juanforozco/Proyecto_Final_DPE/DPE_PFinal_E3/secciones/acronimos.tex

%% ============================================================
%%  Lista de Acrónimos – sin paquete glossaries
%% ============================================================
\chapter*{Lista de Acrónimos}
\addcontentsline{toc}{chapter}{Lista de Acrónimos}

\begin{longtable}{L{2.5cm} L{12cm}}
  \toprule
  \rowcolor{udea-green}
  \textcolor{white}{\textbf{Acrónimo}} &
  \textcolor{white}{\textbf{Significado}} \\
  \midrule
  \endfirsthead
  \rowcolor{udea-green}
  \textcolor{white}{\textbf{Acrónimo}} &
  \textcolor{white}{\textbf{Significado}} \\
  \midrule
  \endhead
  \bottomrule
  \endfoot
  PCB    & Printed Circuit Board (Tarjeta de Circuito Impreso) \\
  \rowcolor{row-alt}
  BOM    & Bill of Materials (Lista de Materiales) \\
  SoC    & System on Chip \\
  \rowcolor{row-alt}
  SoM    & System on Module \\
  ARM    & Advanced RISC Machine \\
  \rowcolor{row-alt}
  MIPI   & Mobile Industry Processor Interface \\
  DSI    & Display Serial Interface \\
  \rowcolor{row-alt}
  I2S    & Inter-IC Sound \\
  I2C    & Inter-Integrated Circuit \\
  \rowcolor{row-alt}
  SPI    & Serial Peripheral Interface \\
  PDM    & Pulse Density Modulation \\
  \rowcolor{row-alt}
  PWM    & Pulse Width Modulation \\
  eMMC   & embedded MultiMediaCard \\
  \rowcolor{row-alt}
  SDIO   & Secure Digital Input/Output \\
  PMIC   & Power Management Integrated Circuit \\
  \rowcolor{row-alt}
  LDO    & Low Dropout Regulator \\
  TVS    & Transient Voltage Suppressor \\
  \rowcolor{row-alt}
  PPTC   & Polymeric Positive Temperature Coefficient (fusible resetable) \\
  EMI    & Electromagnetic Interference \\
  \rowcolor{row-alt}
  EMC    & Electromagnetic Compatibility \\
  SI     & Signal Integrity (Integridad de Señal) \\
  \rowcolor{row-alt}
  PI     & Power Integrity (Integridad de Potencia) \\
  PDN    & Power Distribution Network \\
  \rowcolor{row-alt}
  DRC    & Design Rule Check \\
  ERC    & Electrical Rule Check \\
  \rowcolor{row-alt}
  GUI    & Graphical User Interface \\
  OVOS   & OpenVoiceOS \\
  \rowcolor{row-alt}
  TLS    & Transport Layer Security \\
  OTA    & Over-The-Air (actualización inalámbrica) \\
  \rowcolor{row-alt}
  AEC    & Acoustic Echo Cancellation \\
  SNR    & Signal-to-Noise Ratio \\
  \rowcolor{row-alt}
  THD+N  & Total Harmonic Distortion plus Noise \\
  HDI    & High Density Interconnect \\
  \rowcolor{row-alt}
  BGA    & Ball Grid Array \\
  QFP    & Quad Flat Package \\
  \rowcolor{row-alt}
  DPST   & Double Pole Single Throw \\
  SPCA   & Subsistema de Procesamiento Central y Almacenamiento \\
  \rowcolor{row-alt}
  SAA    & Subsistema de Audio y Acústica \\
  SIVI   & Subsistema de Interfaz Visual e Interacción \\
  \rowcolor{row-alt}
  SGE    & Subsistema de Gestión de Energía \\
  SCR    & Subsistema de Conectividad y Red \\
  \rowcolor{row-alt}
  SPSF   & Subsistema de Privacidad y Seguridad Física \\
\end{longtable}
