juanforozco/Proyecto_Final_DPE/DPE_PFinal_E3/secciones/anexo_d_esquematicos_ctrl.tex

%% ============================================================
%%  Anexo D – Esquemáticos PCB-CTRL (exportados desde Altium)
%% ============================================================
\chapter{Esquemáticos PCB-CTRL}
\label{chap:anexo_esq_ctrl}

\begin{infobox}[Instrucciones para incluir los esquemáticos]
  Exportar los esquemáticos de Altium Designer como PDF
  (\texttt{File > Smart PDF}) y guardar el archivo como
  \texttt{figuras/esq\_pcb\_ctrl.pdf}.
  Descomentar el comando \texttt{\textbackslash includepdf} al finalizar
  el diseño.
\end{infobox}

% Descomentar cuando el PDF de esquemáticos esté disponible:
% \includepdf[pages=-, scale=0.95, pagecommand={}]{figuras/esq_pcb_ctrl.pdf}

% Mientras el PDF no esté disponible, incluir aquí una nota de estado:
\begin{riskbox}[Estado del Esquemático -- PCB-CTRL]
  Esquemático en desarrollo. Fecha esperada de finalización: [fecha].
  El archivo editable está disponible en el repositorio de GitHub del equipo
  bajo \texttt{/altium/PCB-CTRL/}.
\end{riskbox}
