juanforozco/Proyecto_Final_DPE/DPE_PFinal_E3/secciones/anexo_e_esquematicos_pwr.tex

%% ============================================================
%%  Anexo E – Esquemáticos PCB-PWR (exportados desde Altium)
%% ============================================================
\chapter{Esquemáticos PCB-PWR}
\label{chap:anexo_esq_pwr}

\begin{infobox}[Instrucciones para incluir los esquemáticos]
  Exportar los esquemáticos de Altium Designer como PDF
  (\texttt{File > Smart PDF}) y guardar el archivo como
  \texttt{figuras/esq\_pcb\_pwr.pdf}.
  Descomentar el comando \texttt{\textbackslash includepdf} al finalizar
  el diseño.
\end{infobox}

% \includepdf[pages=-, scale=0.95, pagecommand={}]{figuras/esq_pcb_pwr.pdf}

\begin{riskbox}[Estado del Esquemático -- PCB-PWR]
  Esquemático en desarrollo. Fecha esperada de finalización: [fecha].
  El archivo editable está disponible en el repositorio de GitHub del equipo
  bajo \texttt{/altium/PCB-PWR/}.
\end{riskbox}
