juanforozco/Proyecto_Final_DPE/DPE_PFinal_E3/secciones/control_versiones.tex

%% ============================================================
%%  Control de Versiones
%% ============================================================
\chapter*{Control de Versiones}
\addcontentsline{toc}{chapter}{Control de Versiones}

\begin{table}[H]
  \centering
  \caption*{Historial de revisiones del documento}
  \begin{tabularx}{\textwidth}{C{1.5cm} C{2.5cm} L{5cm} L{4.5cm}}
    \toprule
    \rowcolor{udea-green}
    \textcolor{white}{\textbf{Ver.}} &
    \textcolor{white}{\textbf{Fecha}} &
    \textcolor{white}{\textbf{Descripción}} &
    \textcolor{white}{\textbf{Autor(es)}} \\
    \midrule
    1.0 & [25/05/2026] & Versión inicial del documento & Grupo 04 \\
    \bottomrule
  \end{tabularx}
\end{table}
\clearpage
