juanforozco/Proyecto_Final_DPE/DPE_PFinal_E3/secciones/portada.tex

%% ============================================================
%%  Portada – Entregable 3
%% ============================================================
\begin{titlepage}
  \centering
  \vspace*{1cm}

  %% Descomentar cuando el logo esté en figuras/udea_logo.png:
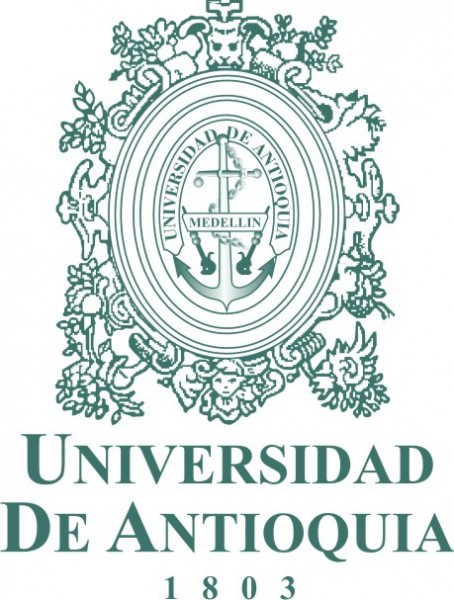
[picture p1: DPE_PFinal_E3/figuras/Escudo UdeA.jpg]
  \\[1cm]

  {\LARGE \textbf{\textcolor{udea-green}{Universidad de Antioquia}}}\\[0.2cm]
  {\large Facultad de Ingeniería}\\
  {\large Departamento de Ingeniería Electrónica y Telecomunicaciones}\\[0.2cm]
  {\large Diseño de Productos Electrónicos}
  \textcolor{udea-green}{\rule{0.6\linewidth}{1.5pt}}\\[0.4cm]
  {\Huge \bfseries \textcolor{udea-green}{Entregable 3}}\\[0.2cm]
  {\LARGE \bfseries Documento de Diseño HW/SW}\\[0.2cm]
  {\Large \textbf{Producto ALMA}}\\[0.2cm]
  \textcolor{udea-green}{\rule{0.6\linewidth}{1.5pt}}\\[1cm]

  {\large
    Miguel Ángel Álvarez Guzmán\\[0.2cm]
    Juan Felipe Orozco Londoño\\[0.2cm]
    Carlos Augusto Quintero Vélez\\[0.6cm]
    \textbf{Grupo 04}
  }\\[2cm]

  {\large Medellín, Colombia \quad -- \quad Mayo de 2026}

  \vfill
\end{titlepage}
\clearpage
