juanforozco/Proyecto_Final_DPE/Proyecto_Final_Digitales/Project Outputs for Main_Board_Diseño/BGA Escape Route - Main_Board.html

Altium customize

# BGA Escape Route

Date: | | 11/06/2026
Time: | | 7:39:33 p. m.
Elapsed Time: | | 00:00:00
Filename: | | C:\Users\Public\Documents\Altium\Proyecto_Final_Digitales\Main_Board.PcbDoc

## BGA Component Pads that can't be escape routed

U5

Pad U5-P1(51.441mm,43.849mm) on L1_Top on No Net

Pad U5-P14(44.941mm,43.849mm) on L1_Top on No Net

Pad U5-A1(51.441mm,37.349mm) on L1_Top on No Net

Pad U5-A14(44.941mm,37.349mm) on L1_Top on No Net

Pad U5-P13(45.441mm,43.849mm) on L1_Top on No Net

Pad U5-A13(45.441mm,37.349mm) on L1_Top on No Net

Pad U5-P2(50.941mm,43.849mm) on L1_Top on No Net

Pad U5-N1(51.441mm,43.349mm) on L1_Top on No Net

Pad U5-N14(44.941mm,43.349mm) on L1_Top on No Net

Pad U5-B1(51.441mm,37.849mm) on L1_Top on No Net

Pad U5-A2(50.941mm,37.349mm) on L1_Top on No Net

Pad U5-B14(44.941mm,37.849mm) on L1_Top on No Net

Pad U5-P3(50.441mm,43.849mm) on L1_Top on Net VDDIO_3V3

Pad U5-M1(51.441mm,42.849mm) on L1_Top on No Net

Pad U5-P12(45.941mm,43.849mm) on L1_Top on No Net

Pad U5-M14(44.941mm,42.849mm) on L1_Top on No Net

Pad U5-C1(51.441mm,38.349mm) on L1_Top on No Net

Pad U5-A3(50.441mm,37.349mm) on L1_Top on Net BOOT_D0

Pad U5-C14(44.941mm,38.349mm) on L1_Top on No Net

Pad U5-A12(45.941mm,37.349mm) on L1_Top on No Net

Pad U5-N13(45.441mm,43.349mm) on L1_Top on No Net

Pad U5-B13(45.441mm,37.849mm) on L1_Top on No Net

Pad U5-N2(50.941mm,43.349mm) on L1_Top on Net GND

Pad U5-B2(50.941mm,37.849mm) on L1_Top on Net BOOT_D3

Pad U5-P4(49.941mm,43.849mm) on L1_Top on Net GND

Pad U5-L1(51.441mm,42.349mm) on L1_Top on No Net

Pad U5-P11(46.441mm,43.849mm) on L1_Top on No Net

Pad U5-D1(51.441mm,38.849mm) on L1_Top on No Net

Pad U5-L14(44.941mm,42.349mm) on L1_Top on No Net

Pad U5-A4(49.941mm,37.349mm) on L1_Top on Net BOOT_D1

Pad U5-D14(44.941mm,38.849mm) on L1_Top on No Net

Pad U5-A11(46.441mm,37.349mm) on L1_Top on No Net

Pad U5-M13(45.441mm,42.849mm) on L1_Top on No Net

Pad U5-C13(45.441mm,38.349mm) on L1_Top on No Net

Pad U5-N3(50.441mm,43.349mm) on L1_Top on No Net

Pad U5-M2(50.941mm,42.849mm) on L1_Top on No Net

Pad U5-N12(45.941mm,43.349mm) on L1_Top on No Net

Pad U5-C2(50.941mm,38.349mm) on L1_Top on Net NetC121_1

Pad U5-B3(50.441mm,37.849mm) on L1_Top on Net BOOT_D4

Pad U5-B12(45.941mm,37.849mm) on L1_Top on No Net

Pad U5-P5(49.441mm,43.849mm) on L1_Top on Net VDDIO_3V3

Pad U5-P10(46.941mm,43.849mm) on L1_Top on No Net

Pad U5-K1(51.441mm,41.849mm) on L1_Top on No Net

Pad U5-E1(51.441mm,39.349mm) on L1_Top on No Net

Pad U5-K14(44.941mm,41.849mm) on L1_Top on No Net

Pad U5-A5(49.441mm,37.349mm) on L1_Top on Net BOOT_D2

Pad U5-E14(44.941mm,39.349mm) on L1_Top on No Net

Pad U5-A10(46.941mm,37.349mm) on L1_Top on No Net

Pad U5-P6(48.941mm,43.849mm) on L1_Top on Net GND

Pad U5-P9(47.441mm,43.849mm) on L1_Top on No Net

Pad U5-J1(51.441mm,41.349mm) on L1_Top on No Net

Pad U5-F1(51.441mm,39.849mm) on L1_Top on No Net

Pad U5-J14(44.941mm,41.349mm) on L1_Top on No Net

Pad U5-F14(44.941mm,39.849mm) on L1_Top on No Net

Pad U5-A6(48.941mm,37.349mm) on L1_Top on Net GND

Pad U5-A9(47.441mm,37.349mm) on L1_Top on No Net

Pad U5-L13(45.441mm,42.349mm) on L1_Top on No Net

Pad U5-D13(45.441mm,38.849mm) on L1_Top on No Net

Pad U5-P7(48.441mm,43.849mm) on L1_Top on No Net

Pad U5-P8(47.941mm,43.849mm) on L1_Top on No Net

Pad U5-H1(51.441mm,40.849mm) on L1_Top on No Net

Pad U5-G1(51.441mm,40.349mm) on L1_Top on No Net

Pad U5-H14(44.941mm,40.849mm) on L1_Top on No Net

Pad U5-G14(44.941mm,40.349mm) on L1_Top on No Net

Pad U5-A7(48.441mm,37.349mm) on L1_Top on No Net

Pad U5-A8(47.941mm,37.349mm) on L1_Top on No Net

Pad U5-N4(49.941mm,43.349mm) on L1_Top on Net VDDIO_3V3

Pad U5-L2(50.941mm,42.349mm) on L1_Top on No Net

Pad U5-N11(46.441mm,43.349mm) on L1_Top on No Net

Pad U5-D2(50.941mm,38.849mm) on L1_Top on No Net

Pad U5-B4(49.941mm,37.849mm) on L1_Top on Net BOOT_D5

Pad U5-B11(46.441mm,37.849mm) on L1_Top on No Net

Pad U5-M3(50.441mm,42.849mm) on L1_Top on No Net

Pad U5-M12(45.941mm,42.849mm) on L1_Top on No Net

Pad U5-C3(50.441mm,38.349mm) on L1_Top on No Net

Pad U5-C12(45.941mm,38.349mm) on L1_Top on No Net

Pad U5-K13(45.441mm,41.849mm) on L1_Top on No Net

Pad U5-E13(45.441mm,39.349mm) on L1_Top on No Net

Pad U5-N5(49.441mm,43.349mm) on L1_Top on Net GND

Pad U5-K2(50.941mm,41.849mm) on L1_Top on No Net

Pad U5-N10(46.941mm,43.349mm) on L1_Top on No Net

Pad U5-E2(50.941mm,39.349mm) on L1_Top on No Net

Pad U5-B5(49.441mm,37.849mm) on L1_Top on Net BOOT_D6

Pad U5-B10(46.941mm,37.849mm) on L1_Top on No Net

Pad U5-J13(45.441mm,41.349mm) on L1_Top on No Net

Pad U5-F13(45.441mm,39.849mm) on L1_Top on No Net

Pad U5-M4(49.941mm,42.849mm) on L1_Top on Net VDDIO_3V3

Pad U5-L3(50.441mm,42.349mm) on L1_Top on No Net

Pad U5-M11(46.441mm,42.849mm) on L1_Top on No Net

Pad U5-D3(50.441mm,38.849mm) on L1_Top on No Net

Pad U5-L12(45.941mm,42.349mm) on L1_Top on No Net

Pad U5-C4(49.941mm,38.349mm) on L1_Top on Net GND

Pad U5-D12(45.941mm,38.849mm) on L1_Top on No Net

Pad U5-C11(46.441mm,38.349mm) on L1_Top on No Net

Pad U5-N6(48.941mm,43.349mm) on L1_Top on No Net

Pad U5-J2(50.941mm,41.349mm) on L1_Top on No Net

Pad U5-N9(47.441mm,43.349mm) on L1_Top on No Net

Pad U5-F2(50.941mm,39.849mm) on L1_Top on No Net

Pad U5-B6(48.941mm,37.849mm) on L1_Top on Net BOOT_D7

Pad U5-B9(47.441mm,37.849mm) on L1_Top on No Net

Pad U5-H13(45.441mm,40.849mm) on L1_Top on No Net

Pad U5-G13(45.441mm,40.349mm) on L1_Top on No Net

Pad U5-N7(48.441mm,43.349mm) on L1_Top on No Net

Pad U5-N8(47.941mm,43.349mm) on L1_Top on No Net

Pad U5-H2(50.941mm,40.849mm) on L1_Top on No Net

Pad U5-G2(50.941mm,40.349mm) on L1_Top on No Net

Pad U5-B7(48.441mm,37.849mm) on L1_Top on No Net

Pad U5-B8(47.941mm,37.849mm) on L1_Top on No Net

Pad U5-M5(49.441mm,42.849mm) on L1_Top on Net BOOT_CMD

Pad U5-K3(50.441mm,41.849mm) on L1_Top on No Net

Pad U5-M10(46.941mm,42.849mm) on L1_Top on No Net

Pad U5-E3(50.441mm,39.349mm) on L1_Top on No Net

Pad U5-K12(45.941mm,41.849mm) on L1_Top on No Net

Pad U5-C5(49.441mm,38.349mm) on L1_Top on No Net

Pad U5-E12(45.941mm,39.349mm) on L1_Top on No Net

Pad U5-C10(46.941mm,38.349mm) on L1_Top on No Net

Pad U5-D4(49.941mm,38.849mm) on L1_Top on No Net

Pad U5-M6(48.941mm,42.849mm) on L1_Top on Net BOOT_CLK

Pad U5-J3(50.441mm,41.349mm) on L1_Top on No Net

Pad U5-M9(47.441mm,42.849mm) on L1_Top on No Net

Pad U5-F3(50.441mm,39.849mm) on L1_Top on No Net

Pad U5-J12(45.941mm,41.349mm) on L1_Top on No Net

Pad U5-C6(48.941mm,38.349mm) on L1_Top on Net VDDIO_3V3

Pad U5-F12(45.941mm,39.849mm) on L1_Top on No Net

Pad U5-C9(47.441mm,38.349mm) on L1_Top on No Net

Pad U5-M7(48.441mm,42.849mm) on L1_Top on No Net

Pad U5-M8(47.941mm,42.849mm) on L1_Top on No Net

Pad U5-H3(50.441mm,40.849mm) on L1_Top on No Net

Pad U5-G3(50.441mm,40.349mm) on L1_Top on No Net

Pad U5-H12(45.941mm,40.849mm) on L1_Top on No Net

Pad U5-G12(45.941mm,40.349mm) on L1_Top on No Net

Pad U5-C7(48.441mm,38.349mm) on L1_Top on No Net

Pad U5-C8(47.941mm,38.349mm) on L1_Top on No Net

Pad U5-K5(49.441mm,41.849mm) on L1_Top on Net BOOT_RST_N

Pad U5-K10(46.941mm,41.849mm) on L1_Top on No Net

Pad U5-E5(49.441mm,39.349mm) on L1_Top on No Net

Pad U5-E10(46.941mm,39.349mm) on L1_Top on No Net

Pad U5-K6(48.941mm,41.849mm) on L1_Top on No Net

Pad U5-J5(49.441mm,41.349mm) on L1_Top on Net GND

Pad U5-K9(47.441mm,41.849mm) on L1_Top on Net VDDIO_BOOT

Pad U5-J10(46.941mm,41.349mm) on L1_Top on Net VDDIO_BOOT

Pad U5-F5(49.441mm,39.849mm) on L1_Top on Net VDDIO_BOOT

Pad U5-E6(48.941mm,39.349mm) on L1_Top on Net VDDIO_BOOT

Pad U5-F10(46.941mm,39.849mm) on L1_Top on No Net

Pad U5-E9(47.441mm,39.349mm) on L1_Top on No Net

Pad U5-K7(48.441mm,41.849mm) on L1_Top on No Net

Pad U5-K8(47.941mm,41.849mm) on L1_Top on Net GND

Pad U5-H5(49.441mm,40.849mm) on L1_Top on Net BOOT_DQS

Pad U5-G5(49.441mm,40.349mm) on L1_Top on Net GND

Pad U5-H10(46.941mm,40.849mm) on L1_Top on Net GND

Pad U5-G10(46.941mm,40.349mm) on L1_Top on No Net

Pad U5-E7(48.441mm,39.349mm) on L1_Top on Net GND

Pad U5-E8(47.941mm,39.349mm) on L1_Top on No Net

Back to top
