juanforozco/Proyecto_Final_DPE/main_2.pdf

image.png

## Diseño de Productos Electrónicos

# Entregable 2: Documento de Especificaciones Técnicas

## Producto ALMA

## Miguel Angel Alvarez Guzman

## Juan Felipe Orozco Londoño

## Carlos Augusto Quintero Velez

Grupo: 04

12 de junio de 2026

# 1 Introducción

El presente documento constituye el Entregable 2 del proyecto ALMA en el marco del curso Diseño de Productos Electrónicos. Su propósito es transformar la lista de requisitos aprobada en el Entregable 1 en una definición técnica completa del sistema, respondiendo a la pregunta central: ¿Qué implica, técnicamente, implementar ALMA?

El Entregable 1 estableció los requisitos funcionales, no funcionales, generales, arquitectónicos y de estándares del asistente de voz ALMA. El presente documento toma esos requisitos como punto de partida y los convierte en especificaciones de ingeniería, identificando parámetros, interfaces, rangos, presupuestos energéticos, restricciones térmicas y alternativas de implementación. No se seleccionan referencias comerciales definitivas ni se presentan esquemáticos completos; el foco está en construir una base técnica sólida para el diseño detallado posterior.

La estructura del documento sigue las cinco etapas metodológicas definidas en la guía: (i) mapeo de requisitos a HW/SW/mixto, (ii) derivación de especificaciones técnicas, (iii) análisis de consistencia e interdependencias, (iv) agrupación en subsistemas y (v) elaboración del diagrama de bloques. Adicionalmente, se presenta una matriz refinada de verificación, y se registran los supuestos, riesgos y decisiones abiertas que condicionarán la siguiente etapa de diseño.

# 2 Metodología de Trabajo

El equipo aplicó las cinco etapas definidas en la guía de desarrollo de la siguiente manera:

Etapa 1 — Mapeo de requisitos (HW/SW/Mixto): A partir de la lista de requisitos del Entregable 1, cada integrante clasificó de forma independiente cada requisito. Las clasificaciones se discutieron en sesión conjunta y se consolidaron en la tabla de trazabilidad del Capítulo ??. La justificación de cada categoría se basó en el criterio de dónde reside principalmente la decisión de diseño: en el silicio, en el firmware/software, o en ambos.

Etapa 2 — Derivación de especificaciones técnicas: Con los requisitos clasificados, cada integrante asignado al área correspondiente (audio, GUI/conectividad/persistencia, potencia/térmica/seguridad) redactó la ficha técnica de cada requisito, definiendo elementos, interfaces, rangos, presupuestos de energía, tiempos de respuesta, restricciones térmicas y alternativas de implementación. El resultado se recoge en el Capítulo ??.

Etapa 3 — Análisis de consistencia e interdependencias: El equipo realizó una reunión de integración técnica en la que se identificaron recursos compartidos, dependencias funcionales, conflictos de diseño y requisitos transversales. Las preguntas guía de la metodología (¿qué recursos se comparten?, ¿qué decisiones entran en conflicto?, ¿qué funciones deben mantenerse juntas?) estructuraron la discusión. Los hallazgos se documentan en el Capítulo ??.

Etapa 4 — Agrupación en subsistemas: Solo tras concluir el análisis de consistencia se procedió a definir los seis subsistemas del producto. La partición no fue arbitraria, sino que surgió de las agrupaciones naturales evidenciadas por las interdependencias detectadas. Cada subsistema se describe en el Capítulo ??.

Etapa 5 — Diagrama de bloques: Como síntesis de las etapas anteriores, se construyó el diagrama de bloques funcional (Capítulo ??), que representa fielmente la arquitectura técnica propuesta, incluyendo interfaces, flujos de datos y distribución de potencia.

Finalmente, se refinaron los criterios de aceptación y métodos de verificación para cada requisito (Capítulo ??), y se registraron los supuestos, riesgos y decisiones abiertas (Capítulo ??).

3 Mapeo de Requisitos (Hardware, Software y Mixto)

# 3 Mapeo de Requisitos (Hardware, Software y Mixto)

Tabla 3.1: Etapa 1: Clasificación de Requisitos del Producto ALMA

ID | Clasificación | Resumen del Requisito | Justificación de la Clasificación
REQ-F-01 | Mixto | Reproducción de audio HD (24-bit/96 kHz) vía I2S. | Requiere la selección física de un có-dec externo y ruteo de señales (HW), además de los drivers de audio en Li-nux y el stack de OpenVoiceOS (SW).
REQ-F-02 | Mixto | Interacción y respuesta por voz a dis-tancia. | Depende de la sensibilidad de los micrófonos y potencia de cómputo ARM64 (HW), y del procesamiento de lenguaje natural y síntesis de voz (SW).
REQ-F-03 | Mixto | Conservación de configuración ante desconexión eléctrica. | Requiere un medio físico de alma-cenamiento no volátil como eMMC o EEPROM (HW) y una lógica de gestión de persistencia en el sistema operativo (SW).
REQ-F-04 | Mixto | Iluminación ambiental RGB integra-da. | Involucra el diseño del circuito de control de LEDs y drivers de potencia (HW) junto con la lógica de control de estados y efectos visuales (SW).
REQ-NF-01 | Hardware | Silenciado de micrófonos mediante switch físico con indicador. | La guía exige explícitamente un con-trol que actúe a nivel de hardware para garantizar la privacidad sin de-pendencia del software.
REQ-NF-02 | Software | Control de otros dispositivos inteli-gentes como cliente IP. | Se basa primordialmente en la im-plementación de protocolos de red y comunicación interoperable sobre la infraestructura IP existente.
REQ-G-01 | Mixto | Interfaz gráfica táctil conectada por MIPI DSI. | Requiere el ruteo de pares diferen-ciales de alta velocidad y conexión física del panel (HW), y el desarrollo del framework de la GUI y drivers gráficos (SW).
REQ-A-01 | Hardware | Gestión térmica para operación en entorno doméstico. | El cumplimiento depende del dise-ño físico de la PCB (planos de tie-rra, vías térmicas) y la disposición de componentes para disipación pasiva.
REQ-E-01 | Hardware | Cumplimiento de seguridad eléctrica (IEC 62368-1). | Involucra decisiones de diseño físico como aislamientos, protecciones con-tra sobretensión y selección de mate-riales para prevenir riesgos eléctricos.
REQ-E-02 | Mixto | Baseline de ciberseguridad para IoT (ETSI EN 303 645). | Requiere protecciones físicas de puer-tos y arranque seguro (HW), además de mecanismos de autenticación y ci-frado de datos en tránsito (SW).

# 4 Especificaciones Técnicas Detalladas

En este capítulo se desglosan las implicaciones técnicas de cada requisito, definiendo los parámetros de diseño necesarios para la implementación del hardware y software de ALMA. Para cada requisito se incluye, además de las especificaciones técnicas, el criterio de aceptación refinado y el método de verificación refinado, tal como lo exige la guía [?].

## 4.1. REQ-F-01: Reproducción de Audio HD (I2S)

Elementos: SoC ARM64, Códec de audio externo, Amplificador Clase D.

Interfaces: Bus I2S (BCLK, LRCLK, DIN/DOUT) e interfaz I2C para configuración del registro del códec.

Tasas y Resoluciones: Muestreo de 96 kHz con profundidad de 24 bits. Ancho de banda de audio de 20 Hz a 40 kHz.

Rangos de Tensión/Potencia: 3.3V (Digital), 5V–12V (Etapa de potencia). Consumo pico de 10 W en reproducción máxima.

Dependencias: Requiere el bloque de gestión de reloj del SoC y drivers ALSA en Linux.

Alternativas de implementación:

- Opción A (seleccionada): Códec externo con interfaz I2S. Mayor calidad de audio y menor latencia; exige ruteo cuidadoso de señales de reloj y blindaje de la etapa analógica.
- Opción B: DAC con interfaz USB. Simplifica el ruteo de alta velocidad en la PCB, pero incrementa la latencia de salida (tipicamente ≥5 ms adicionales) y añade un nodo de alimentación extra.

Criterio de aceptación refinado: THD+N < 0.01 %, SNR > 100 dB (pesado con A), respuesta en frecuencia plana ±3 dB en 20 Hz–40 kHz, todo medido a plena escala y 24-bit/96 kHz en condiciones de temperatura nominal (25 °C).

Método de verificación refinado: Medición con analizador de audio de doble canal (ej. APx515 o equivalente) utilizando señal de barrido sinusoidal. Se aplicará la norma AES17 para la supresión del fundamental durante la medición de THD+N.

## 4.2. REQ-F-02: Interacción y Respuesta por Voz

Elementos: Matriz de 2 o 4 micrófonos MEMS digitales, Altavoz de rango completo.

Interfaces: PDM (Pulse Density Modulation) para los micrófonos o I2S.

Tiempos de Respuesta: Latencia de detección de wake-word < 500 ms; latencia de inicio de respuesta < 2 s.

Condiciones de Operación: Captura efectiva de voz en un radio de 5 metros con ruido ambiental de hasta 60 dB SPL.

Dependencia: Bloque funcional de Procesamiento Digital de Señales (DSP) para cancelación de eco (AEC) y supresión de ruido (NS).

4 Especificaciones Técnicas Detalladas

Alternativas de implementación:

- Opción A: Micrófonos MEMS digitales PDM — mayor inmunidad a EMI, procesamiento directo en el SoC.
- Opción B: Micrófonos analógicos con ADC externo — menor costo unitario, mayor complejidad de ruteo y riesgo de ruido de modo común.

Criterio de aceptación refinado: Tasa de detección del wake-word ≥ 95 % (Word Error Rate ≤ 5 %) a 5 m con ruido de fondo de 60 dB SPL. Latencia de detección < 500 ms y de respuesta completa < 2 s, medidos desde el final del enunciado.

Método de verificación refinado: Prueba en entorno controlado con fuente de ruido calibrada (ruido rosa a 60 dB SPL). Se ejecutarán 200 locuciones del wake-word desde distintas posiciones a 5 m. Se medirá la latencia con timestamps en el log del sistema.

## 4.3. REQ-F-03: Persistencia de Datos

Necesidades de Almacenamiento: Memoria no volátil (eMMC en SoC o EEPROM externa). Capacidad mínima de 256 KB para logs y configuración.

Interfaces: Bus SDIO para eMMC o I2C/SPI para memorias auxiliares.

Protección: Implementación de sumas de comprobación (Checksum CRC-32) para evitar corrupción de datos durante cortes de energía.

Alternativas de implementación:

- Opción A (seleccionada): Almacenamiento local en eMMC con partición protegida contra escritura.
- Opción B: Almacenamiento en la nube (SaaS) — viola el requisito de funcionamiento local de configuraciones críticas; descartada.

Criterio de aceptación refinado: Tras un corte abrupto de alimentación durante una operación de escritura, el sistema debe restaurar la última configuración válida con integridad verificada por CRC-32 en un tiempo ≤ 10 s desde el reinicio.

Método de verificación refinado: Se programará una rutina automatizada que realice escrituras periódicas en la memoria y corte la alimentación aleatoriamente durante el proceso. Se verificará post-reinicio la integridad del archivo de configuración mediante comprobación del CRC almacenado. Se repetirá el ciclo un mínimo de 50 veces.

## 4.4. REQ-F-04: Iluminación Ambiental RGB

Elementos: Controlador PWM dedicado o LEDs inteligentes (tipo WS2812B).

Presupuestos de Energía: 5V DC, máximo 60 mA por cada LED a brillo total. Presupuesto total de iluminación: 1.5 W.

Interfaces: Un hilo (One-wire) o GPIO con soporte de PWM de alta frecuencia (≥ 200 Hz para eliminar parpadeo perceptible).

Alternativas de implementación:

- Opción A: LEDs inteligentes WS2812B gestionados por GPIO del SoC — mínimo hardware externo, pero genera carga de CPU en tiempo real.

4 Especificaciones Técnicas Detalladas

- Opción B (recomendada): Microcontrolador de bajo consumo independiente (Cortex-M0) para gestionar efectos visuales — desacopla la carga del SoC y permite efectos en modo de espera sin encender el núcleo principal.

Criterio de aceptación refinado: Frecuencia de PWM ≥ 200 Hz (sin parpadeo perceptible a < 1 m), reproducción de al menos 16M colores, transición suave entre estados en ≤ 200 ms, y consumo máximo del subsistema RGB ≤ 1.5 W.

Método de verificación refinado: Medición de la frecuencia de PWM con osciloscopio digital. Verificación de la gama de colores con colorímetro. Medición de consumo con multímetro de precisión en el riel de 5V durante operación a brillo total.

## 4.5. REQ-NF-01: Silenciado Físico de Micrófonos

Elementos: Switch mecánico DPST (Double Pole Single Throw) e indicador LED rojo.

Requerimientos de Seguridad: El corte debe ser galvánico o mediante interrupción de la línea de alimentación (VCC) de los micrófonos. El software no debe tener ninguna capacidad de anular el estado del switch.

Interfaces: Conexión directa hard-wired (sin intervención del software).

Restricciones: El LED indicador debe ser alimentado directamente por el mismo circuito del switch, sin pasar por ningún GPIO del SoC.

Alternativas de implementación: No aplica — la guía del proyecto exige explícitamente implementación hardware pura; cualquier variante software queda descartada por diseño.

Criterio de aceptación refinado: Con el switch en posición de silenciado, la resistencia medida en la línea de alimentación de los micrófonos debe ser > 10 MΩ (circuito abierto). El LED rojo debe encenderse simultáneamente, incluso con el SoC apagado o en estado de pánico del kernel.

Método de verificación refinado: Medición de continuidad con multímetro en la línea VCC de los micrófonos con switch activo. Verificación de independencia del software induciendo un bloqueo del sistema operativo (kernel panic) y confirmando que el LED permanece encendido y los micrófonos sin alimentación.

## 4.6. REQ-NF-02: Control de Dispositivos (Cliente IP)

Interfaces: WiFi 802.11n (2.4 GHz) y/o Ethernet 10/100 Mbps.

Tasas de transferencia: Mínimo 10 Mbps para asegurar actualizaciones de firmware (OTA) fluidas.

Protección: Implementación de protocolos TLS 1.3 para toda comunicación saliente.

Alternativas de implementación:

- Opción A: WiFi integrado en el SoC — reduce componentes externos pero puede generar interferencias de RF con la etapa de audio.
- Opción B: Módulo WiFi/BT externo vía SDIO o USB — mayor flexibilidad de posicionamiento de antena, aislamiento de RF más sencillo.

Criterio de aceptación refinado: Latencia de control bidireccional con dispositivos IP en la red local < 200 ms (percentil 95). Verificación de cifrado TLS 1.3 activo en todas las conexiones salientes. Tasa de transferencia efectiva en OTA ≥ 10 Mbps en condiciones de señal WiFi ≥ -70 dBm.

4 Especificaciones Técnicas Detalladas

Método de verificación refinado: Medición de latencia de comando-respuesta con herramienta de red (ping y pruebas de capa de aplicación). Inspección del tráfico cifrado con Wireshark para confirmar TLS 1.3. Prueba de velocidad OTA con imagen de firmware de 100 MB y cronómetro de sistema.

## 4.7. REQ-G-01: Interfaz Gráfica (GUI) Táctil

Componentes de la GUI: Panel LCD TFT/OLED de 5 a 7 pulgadas, digitalizador capacitivo.

Interfaces: MIPI DSI (4 carriles diferenciales) para video; I2C para el panel táctil.

Resolución: Mínimo 800×480 píxeles, tasa de refresco de 60 fps.

Presupuestos de Energía: Retroiluminación (Backlight) de 3.3V a 12V con convertidor Boost dedicado (consumo ≈2 W).

Alternativas de implementación:

- Opción A (seleccionada): Panel TFT con MIPI DSI — alta disponibilidad, bajo costo, resolución suficiente.
- Opción B: Panel OLED — mejor contraste y menor consumo en fondos oscuros, pero mayor costo y riesgo de burn-in en uso continuo doméstico.

Criterio de aceptación refinado: Resolución efectiva de ≥800×480 px a 60 fps estables (sin tearing ni frame drops > 1 %). Latencia táctil < 100 ms desde contacto hasta respuesta visual. Brillo mínimo > 300 cd/m² a temperatura ambiente.

Método de verificación refinado: Medición de frame rate con herramienta de debug gráfico (ej. framerate_monitor en Linux). Latencia táctil medida con cámara de alta velocidad (240 fps). Brillo medido con luxómetro calibrado
a 10 cm de la pantalla.

## 4.8. REQ-A-01: Gestión Térmica

Restricciones Térmicas: Temperatura de unión (Tj ) del SoC < 105 °C. Temperatura de carcasa externa < 45 °C.

Condiciones de Operación: Funcionamiento estable en ambientes de 0 °C a 40 °C con humedad relativa de 10 % a 90 % no condensante.

Elementos: Disipador de calor pasivo de aluminio y thermal pads de alta conductividad (> 3 W/mK).

Alternativas de implementación:

- Opción A (seleccionada): Disipación pasiva mediante carcasa de aluminio como heatsink. Sin ruido, sin piezas móviles.
- Opción B: Ventilador activo de bajo perfil — permite disipar más calor pero añade ruido acústico inaceptable para un producto doméstico y reduce la fiabilidad mecánica.

Criterio de aceptación refinado: Temperatura de unión del SoC < 105 °C y temperatura de carcasa < 45 °C tras 60 minutos de operación a carga máxima (audio pico + GUI activa + voz) en cámara ambiental a 40 °C. Sin thermal throttling detectable en el log del kernel.

Método de verificación refinado: Cámara termográfica de infrarrojo y termopares pegados en puntos críticos (zona SoC, zona amplificador de audio, superficie de carcasa). Monitoreo de la frecuencia real del SoC con cpufreq-info durante la prueba para detectar throttling.

4 Especificaciones Técnicas Detalladas

## 4.9. REQ-E-01: Seguridad Eléctrica (IEC 62368-1)

Rangos de Tensión: Entrada de alimentación de 12V DC ± 5 %.

Requerimientos de Protección: Diodos TVS en todos los conectores externos, fusible resetable (PPTC) en la entrada principal.

Protección: Diseño de PCB con distancias de seguridad (clearance) según la norma IEC 62368-1 para evitar arcos eléctricos.

Alternativas de implementación:

- Opción A (seleccionada): Protecciones discretas (TVS + PPTC) — menor costo, trazabilidad clara del circuito de protección.
- Opción B: Integración en un único IC de protección — reduce espacio en PCB pero añade dependencia de un componente propietario.

Criterio de aceptación refinado: Superación de prueba de rigidez dieléctrica (hi-pot) a 500 V DC durante 60 s sin fallo. Cumplimiento de distancias de clearance y creepage según Tabla F.1 de IEC 62368-1. Disparo del PPTC en < 5 s ante cortocircuito en la entrada.

Método de verificación refinado: Inspección de DRC (Design Rule Check) en el software EDA con reglas derivadas de IEC 62368-1. Prueba hi-pot con equipo certificado en el prototipo físico. Medición del tiempo de disparo del PPTC con cortocircuito controlado y osciloscopio.

## 4.10. REQ-E-02: Ciberseguridad (ETSI EN 303 645)

Elementos de Procesamiento: Uso de TrustZone (ARM) o un elemento seguro (TPM) externo para almacenamiento de llaves.

Necesidades de Almacenamiento: Partición de arranque (Boot) protegida contra escritura.

Alternativas de implementación:

- Opción A: ARM TrustZone integrado en el SoC — sin costo adicional de componente, pero dependiente de la implementación del fabricante del SoC.
- Opción B (recomendada como complemento): Secure Element dedicado (ej. ATECC608B) para gestión de identidad de hardware — independiente del SoC, mayor garantía de aislamiento criptográfico.

Criterio de aceptación refinado: Cadena de arranque seguro (Secure Boot) verificada y funcional; credenciales únicas por dispositivo (ninguna contraseña por defecto compartida); actualizaciones OTA firmadas y verificadas antes de aplicar; cumplimiento de los 13 controles mandatorios de ETSI EN 303 645 [?].

Método de verificación refinado: Análisis de superficie de ataque mediante pen-testing básico (escaneo de puertos, intento de acceso con credenciales por defecto). Verificación del arranque seguro intentando flashear firmware sin firma. Auditoría manual contra la lista de verificación de ETSI EN 303 645.

# 5 Análisis de Consistencia e Interdependencias

Este capítulo evalúa la coherencia técnica del sistema ALMA de forma integral, identificando cómo interactúan los requisitos entre sí y detectando posibles cuellos de botella o conflictos de diseño antes de proceder a la partición en subsistemas [?].

## 5.1. Presupuesto Energético Consolidado

Se realiza una estimación de la carga máxima para validar que la entrada de alimentación de 12V (REQ-E-01) es suficiente:

SoC ARM64 + Conectividad: 5 W (estimado en carga alta).

Etapa de Audio (REQ-F-01): 10 W (pico en máxima potencia).

Pantalla y Backlight (REQ-G-01): 2.5 W.

Iluminación RGB (REQ-F-04): 1.5 W.

Total Estimado: 19 W.

Consistencia: Una fuente de 12V DC a 2 A (24 W) proporciona un margen de seguridad del 20 %, cumpliendo con los requerimientos de potencia. Se recomienda escalar a 2.5 A para absorber picos transitorios del amplificador Clase D.

## 5.2. Compatibilidad de Recursos Críticos

Se han identificado los siguientes recursos compartidos que condicionan el diseño del hardware:

Capacidad de Cómputo (SoC ARM64): Es el recurso más solicitado. Debe gestionar simultáneamente la GUI (MIPI DSI), el procesamiento de voz (OpenVoiceOS), el cliente de red IP y el stack de audio de alta resolución.

Buses de Alta Velocidad: El espacio físico en la PCB es limitado. El ruteo de los 4 carriles de MIPI DSI debe convivir con las líneas de datos I2S y PDM sin generar interferencias cruzadas (crosstalk). Se requerirán capas de referencia dedicadas en la PCB multicapa.

Fuente de Alimentación (12V DC): Debe derivar voltajes para componentes con necesidades opuestas: 1.2V–1.8V para el núcleo del SoC (alta estabilidad), 3.3V para periféricos, y 5V–12V para la etapa de potencia de audio y retroiluminación de pantalla (altas corrientes).

Recursos del SoC: Se requiere que el SoC ARM64 cuente con al menos: 1× MIPI DSI (4 lanes), 1× I2S (Audio), 1× PDM/I2S (Micrófonos), 2× I2C (Touch y Códec), y 1× SDIO (Memoria/WiFi). La mayoría de los SoCs industriales modernos (tipo i.MX8 o RK3399) cumplen con esta densidad de periféricos.

5 Análisis de Consistencia e Interdependencias

## 5.3. Interdependencias Funcionales

El cumplimiento de ciertos requisitos está encadenado a la existencia de otros:

Interacción por voz ↔ Plataforma de cómputo y Audio: El REQ-F-02 (Voz) es imposible de cumplir sin una latencia mínima en el bus I2S/PDM y sin la potencia de procesamiento necesaria para ejecutar los modelos de lenguaje localmente.

Control de dispositivos por IP ↔ Conectividad y Seguridad: El REQ-NF-02 depende de una conexión WiFi/Ethernet estable y, según la norma ETSI EN 303 645 [?], de la implementación de llaves criptográficas en el hardware.

Conservación de configuración ↔ Almacenamiento no volátil: La persistencia (REQ-F-03) depende directamente de la selección de una memoria con suficientes ciclos de escritura (>10000 ciclos P/E para eMMC) y de la integridad de la línea de 3.3V durante el apagado.

Integridad de señal MIPI ↔ Diseño PCB: El REQ-G-01 impone una interdependencia crítica con el diseño físico de la PCB. Las señales de alta velocidad deben estar alejadas de la etapa de potencia de audio para evitar EMI.

## 5.4. Conflictos y Tensiones de Diseño

Se han detectado los siguientes puntos de fricción que requieren compromisos de ingeniería:

Audio de alta potencia vs. Sensibilidad de micrófonos: El volumen requerido para el altavoz (REQ-F-01) genera vibraciones mecánicas y ruido eléctrico que pueden degradar la SNR de los micrófonos MEMS. Se requiere aislamiento físico (mecánico y de PCB) en el diseño final.

Brillo de pantalla vs. Disipación térmica: El uso de la GUI (REQ-G-01) al máximo brillo incrementa significativamente el calor dentro de la carcasa, lo que presiona el límite térmico del SoC (REQ-A-01). Se deberá implementar control adaptivo del brillo en función de la temperatura.

Procesamiento local intenso vs. Costo: Ejecutar OpenVoiceOS de forma fluida requiere un SoC con mayor RAM y desempeño, lo cual tensiona el presupuesto de costos frente a una solución basada en la nube.

Disipación pasiva vs. Factor de forma: La disipación pasiva (REQ-A-01) depende directamente de la potencia total disipada (≈19 W). El encapsulado del producto debe permitir un flujo de aire mínimo o actuar como parte del disipador para evitar thermal throttling, lo cual afectaría los tiempos de respuesta de voz (REQ-F-02).

## 5.5. Requisitos Transversales

Los siguientes requisitos atraviesan toda la arquitectura y no pueden asignarse a un solo bloque:

Integridad de Señal: Afecta tanto al audio HD (REQ-F-01), como a la pantalla MIPI (REQ-G-01) y a la conectividad de red (REQ-NF-02).

Privacidad y Seguridad: El interruptor físico de micrófonos (REQ-NF-01) y el cumplimiento de IEC 62368-1 [?] son mandatorios en cada etapa del diseño eléctrico.

Cumplimiento Normativo: Las distancias de seguridad en la PCB y la protección contra EMI deben aplicarse en todos los nodos de la placa.

5 Análisis de Consistencia e Interdependencias

Gestión Energética: El presupuesto de potencia (19 W estimados) es un requisito transversal que condiciona la selección de la fuente de alimentación, los reguladores y el diseño térmico.

## 5.6. Decisiones Abiertas y Pendientes

Aspectos que aún no se han definido y que impactarán la arquitectura final:

Modelo específico del SoC: La cantidad de pines y el tipo de encapsulado (BGA vs. QFP) definirá si la PCB será de 4 o 6 capas y el nivel de complejidad de fabricación.

Tipo de Micrófonos: La decisión entre PDM (digital) o Analógicos con ADC externo cambiará la complejidad del ruteo y el uso de recursos del SoC.

Forma de integración del SoC: System-on-Module (SoM) vs. diseño chip-down. El SoM reduce el tiempo de diseño y la complejidad de ruteo de RAM, pero incrementa el costo unitario.

Protocolo de domótica: La implementación del cliente IP (REQ-NF-02) deberá definir qué estándares soportará (Matter, Zigbee sobre IP, HomeKit, etc.), lo que determinará los requisitos de procesamiento del stack de red.

# 6 Partición en Subsistemas y Definición de la Arquitectura

A partir del análisis de interdependencias, se ha definido una arquitectura modular compuesta por seis subsistemas principales. Esta partición facilita el diseño paralelo y asegura que los requisitos transversales (privacidad, seguridad y térmica) se gestionen en cada bloque correspondiente [?].

## 6.1. Subsistema 1: Procesamiento Central y Almacenamiento (SPCA)

Función principal: Ejecutar el sistema operativo Linux (ARM64), gestionar la lógica de OpenVoiceOS y coordinar el flujo de datos entre todos los periféricos.

Especificaciones técnicas asociadas:

- Procesador ARM64 (REQ-F-02).
- Memoria eMMC/SDIO para almacenamiento no volátil de 256 KB – 4 GB (REQ-F-03).
- Soporte para ARM TrustZone (REQ-E-02).

Interfaces: Salida MIPI DSI, buses I2S/PDM para audio, I2C/SPI para control de sensores y SDIO para memoria.

Restricciones relevantes: Temperatura de unión Tj < 105◦C. Requiere PCB de alta densidad (HDI) para fan-out de encapsulado BGA.

Alternativas de implementación: Uso de un System-on-Module (SoM) para reducir la complejidad de ruteo de RAM, frente al diseño chip-down para optimizar costos a gran escala.

## 6.2. Subsistema 2: Audio y Acústica (SAA)

Función principal: Capturar comandos de voz mediante una matriz de micrófonos y reproducir audio de alta fidelidad.

Especificaciones técnicas asociadas:

- Códec externo con resolución de 24-bit/96 kHz (REQ-F-01).
- Amplificador Clase D con potencia pico de 10 W.
- Respuesta en frecuencia de 20 Hz a 40 kHz.

Interfaces: Entrada de reloj y datos vía I2S desde el SPCA; configuración vía I2C.

Restricciones relevantes: SNR de micrófonos > 60 dB. Necesidad de aislamiento mecánico para evitar que las vibraciones del altavoz activen falsamente los micrófonos.

Alternativas de implementación: Micrófonos digitales PDM (mayor inmunidad al ruido) vs. micrófonos analógicos con ADC externo (menor costo unitario).

6 Partición en Subsistemas y Definición de la Arquitectura

## 6.3. Subsistema 3: Interfaz Visual e Interacción (SIVI)

Función principal: Proporcionar retroalimentación visual al usuario y permitir la interacción táctil y lumínica ambiental.

Especificaciones técnicas asociadas:

- Pantalla TFT/OLED con resolución 800×480 a 60 fps (REQ-G-01).
- Panel táctil capacitivo con latencia < 100 ms.
- Control de iluminación RGB mediante PWM o LEDs direccionables (REQ-F-04).

Interfaces: Enlace MIPI DSI de 4 carriles; bus I2C para el controlador táctil.

Restricciones relevantes: Impedancia diferencial controlada de 100 Ω ± 10 %. Presupuesto térmico limitado para el backlight de la pantalla.

## 6.4. Subsistema 4: Gestión de Energía (SGE)

Función principal: Convertir y regular la entrada de energía externa para alimentar de forma estable todos los subsistemas.

Especificaciones técnicas asociadas:

- Entrada de 12V DC ±5 %.
- Reguladores de voltaje para rieles de 1.2V, 1.8V, 3.3V y 5V.
- Eficiencia energética mínima del 85 %.

Interfaces: Salidas de potencia (VCC) hacia todos los subsistemas.

Restricciones relevantes: Cumplimiento de la norma IEC 62368-1 [?]. Protección contra cortocircuito y sobretensión mediante TVS y fusibles (REQ-E-01).

Alternativas de implementación: Uso de un PMIC dedicado (menor espacio, mayor integración) frente a reguladores Buck discretos (mayor control de diseño, menor costo unitario).

## 6.5. Subsistema 5: Conectividad y Red (SCR)

Función principal: Gestionar la comunicación del dispositivo con la red local y servicios externos bajo protocolos IP.

Especificaciones técnicas asociadas:

- WiFi 802.11n (2.4 GHz) o Ethernet 10/100 Mbps (REQ-NF-02).
- Soporte para TLS 1.3 en todas las conexiones salientes.

Interfaces: Bus SDIO o USB hacia el SPCA.

Restricciones relevantes: El diseño de la antena debe estar alejado de las fuentes de ruido del amplificador de audio y la pantalla para evitar degradación de la SNR de RF.

6 Partición en Subsistemas y Definición de la Arquitectura

## 6.6. Subsistema 6: Privacidad y Seguridad Física (SPSF)

Función principal: Garantizar el control del usuario sobre la privacidad del dispositivo mediante hardware, sin posibilidad de anulación por software.

Especificaciones técnicas asociadas:

- Switch mecánico DPST de interrupción física (REQ-NF-01).
- Indicador LED de estado "Silenciado"(hard-wired).

Interfaces: Intercepción de las líneas de alimentación/señal del subsistema SAA.

Restricciones relevantes: Prohibición estricta de bypass por software. El estado del switch debe ser visible incluso si el SPCA está bloqueado o apagado.

# 7 Diagrama de Bloques Funcionales

Como resultado de la partición lógica del sistema y el análisis de interdependencias, se ha construido el diagrama de bloques funcional del producto ALMA. Este esquema (Figura ??) representa de manera fiel y explícita la arquitectura técnica propuesta por el equipo de diseño, detallando los flujos de datos, interfaces físicas y la distribución de potencia [?].

7 Diagrama de Bloques Funcionales

diagrama.png

Figura 7.1: Diagrama de bloques funcional de ALMA, mostrando subsistemas e interfaces.

## 7.1. Descripción del Flujo Arquitectónico

El diagrama de bloques se articula alrededor del Subsistema de Procesamiento Central (SPCA), gobernado por el SoC ARM64. Las relaciones principales operan de la siguiente manera:

Flujo de Audio y Procesamiento: El audio ambiental es captado por la matriz de micrófonos y digitalizado

7 Diagrama de Bloques Funcionales

hacia el Subsistema de Audio (SAA). El SoC intercambia datos de audio puro de alta resolución (24-bit/96 kHz) a través del bus I2S, mientras que la configuración de registros del códec se realiza paralelamente por I2C.

Gestión de Privacidad Estricta: Se ilustra explícitamente cómo el Subsistema de Privacidad (SPSF) interviene de manera hard-wired sobre el hardware de audio. El switch mecánico corta físicamente la alimentación de la matriz de micrófonos y enciende el LED rojo, garantizando privacidad sin dependencia del software [?].

Flujo de Interfaz Gráfica (GUI): El SoC transfiere video de alta velocidad hacia el Subsistema Visual (SIVI) mediante 4 carriles diferenciales MIPI DSI. El retorno de interacciones del usuario se captura a través del bus I2C desde el controlador del panel táctil.

Distribución de Potencia Compartida: El Subsistema de Gestión de Energía (SGE) actúa como la columna vertebral de la placa. Recibe los 12V externos y genera los rieles necesarios para todos los bloques. Se destaca la separación lógica de los rieles de alta corriente (12V/5V para audio y pantalla) frente a los rieles de bajo voltaje y alta estabilidad (1.2V/1.8V) exigidos por el núcleo del SoC.

Esta topología confirma la viabilidad técnica para enrutar los componentes en la PCB, previendo las necesidades de integridad de señal en los buses de alta velocidad (MIPI, USB) y protegiendo las trazas analógicas del códec.

# 8 Matriz Refinada de Verificación

La siguiente tabla consolida, para cada requisito, el criterio de aceptación y el método de verificación refinados respecto al Entregable 1. Esta refinación es resultado del mayor nivel de detalle técnico alcanzado en el presente documento [?].

Tabla 8.1: Matriz refinada de criterios de aceptación y métodos de verificación

ID | Criterio de Aceptación Refinado | Método de Verificación Refinado
REQ-F-01 | THD+N < 0.01 %, SNR > 100 dB (A-pesado), respuesta en frecuencia plana ±3 dB en 20 Hz–40 kHz a 24-bit/96 kHz y temperatura nominal. | Medición con analizador de audio de doble canal (conforme AES17). Barrido sinusoidal en todo el rango de frecuencia.
REQ-F-02 | WER ≤ 5 % a 5 m con ruido de fondo de 60 dB SPL. Latencia de detección < 500 ms y latencia de respuesta completa < 2 s. | Prueba en entorno controlado: 200 locuciones del wake-word desde 5 m con fuente de ruido rosa calibrada. Latencia medida con timestamps del sistema.
REQ-F-03 | Configuración restaurada con integridad verificada por CRC-32 en ≤ 10 s tras corte abrupto de energía durante escritura. | Rutina automatizada de escritura con corte aleatorio de alimentación. Verificación CRC post-reinicio. Mínimo 50 ciclos.
REQ-F-04 | PWM ≥ 200 Hz (sin parpadeo perceptible), ≥16M colores, transición entre estados ≤ 200 ms, consumo ≤ 1.5 W. | Medición de frecuencia PWM con osciloscopio. Verificación de gama de colores con colorímetro. Consumo con multímetro en el riel de 5V a brillo total.
REQ-NF-01 | Resistencia > 10 MΩ en la línea VCC de micrófonos con switch activo. LED rojo encendido sin dependencia del SoC. | Medición de continuidad con multímetro. Prueba de independencia del SW induciendo kernel panic y verificando estado del LED y VCC.
REQ-NF-02 | Latencia de control IP < 200 ms (p95). TLS 1.3 activo en todas las conexiones salientes. Velocidad OTA ≥ 10 Mbps a señal ≥ -70 dBm. | Medición de latencia a nivel de aplicación. Inspección de tráfico con Wireshark. Prueba de velocidad OTA con imagen de 100 MB.
REQ-G-01 | Resolución ≥800×480 px a 60 fps (< 1 % de frames perdidos). Latencia táctil < 100 ms. Brillo > 300 cd/m². | Medición de frame rate con herramientas de debug Linux. Latencia táctil con cámara de alta velocidad (240 fps). Brillo con luxómetro a 10 cm.
REQ-A-01 | Tj del SoC < 105 °C y carcasa < 45 °C tras 60 min en carga máxima a 40 °C ambiente, sin thermal throttling. | Termografía IR + termopares en puntos críticos. Monitoreo de frecuencia CPU con cpufreq-info durante la prueba.
REQ-E-01 | Supera prueba hi-pot a 500 V DC / 60 s sin fallo. Distancias de clearance y creepage según Tabla F.1 de IEC 62368-1. PPTC dispara en < 5 s ante cortocircuito. | DRC en EDA con reglas de IEC 62368-1. Prueba hi-pot con equipo certificado en prototipo. Medición de tiempo de disparo del PPTC con osciloscopio.

Continúa en la siguiente página. . .

8 Matriz Refinada de Verificación

ID | Criterio de Aceptación Refinado | Método de Verificación Refinado
REQ-E-02 | Secure Boot funcional; credenciales únicas por dispositivo; OTA con firma verificada; cumplimiento de los 13 controles mandatorios de ETSI EN 303 645. | Pen-testing: escaneo de puertos, intento de acceso con credenciales por defecto, intento de flash sin firma. Auditoría contra lista de verificación de ETSI EN 303 645.

# 9 Supuestos, Riesgos y Decisiones Abiertas

## 9.1. Supuestos de Diseño

Los siguientes supuestos han sido adoptados para el desarrollo de las especificaciones técnicas. Si alguno de ellos cambia, deberá revisarse la sección correspondiente del documento:

S-01: El SoC ARM64 seleccionado contará con al menos 1× MIPI DSI (4 lanes), 2× I2S, 2× I2C, 1× PDM y 1× SDIO. Si el SoC seleccionado no dispone de todos estos periféricos, se requerirán expansores de bus externos.

S-02: El producto operará conectado a una fuente de 12V DC suministrada por un adaptador externo certificado bajo IEC 62368-1. No se contempla alimentación por batería en esta revisión.

S-03: La disipación térmica pasiva es suficiente para los 19 W estimados asumiendo que la carcasa metálica de aluminio actúa como disipador primario y que el entorno garantiza al menos 5 cm de separación lateral para circulación de aire natural.

S-04: OpenVoiceOS se ejecutará de forma completamente local (sin dependencia de servicios en la nube) para los comandos de domótica básica. Los servicios de nube son opcionales y no forman parte del alcance de los requisitos actuales.

S-05: El modelo de wake-word preentrenado disponible en OpenVoiceOS tiene una tasa de falsos positivos aceptable (< 1 por hora) en condiciones de uso doméstico normal.

## 9.2. Riesgos Identificados

R-01 — Disponibilidad del SoC (Alta probabilidad / Alto impacto): La escasez global de semiconductores puede dificultar la obtención del SoC ARM64 de alto desempeño requerido. Mitigación: identificar al menos dos fabricantes alternativos (ej. NXP i.MX8 y Rockchip RK3399) con periféricos equivalentes antes de la fase de diseño de esquemáticos.

R-02 — EMI entre subsistemas (Media probabilidad / Alto impacto): La coexistencia de señales de alta velocidad (MIPI DSI, I2S) con el amplificador Clase D puede generar interferencias que degraden la SNR de los micrófonos y la integridad de la señal de video. Mitigación: diseño de PCB multicapa con planos de tierra dedicados y separación física de zonas analógica, digital y de potencia.

R-03 — Disipación térmica insuficiente (Media probabilidad / Alto impacto): Si la carcasa no puede actuar eficientemente como disipador pasivo, el SoC podría entrar en thermal throttling, degradando la experiencia de voz. Mitigación: simulación térmica (CFD básico) antes de la fabricación del primer prototipo.

R-04 — Latencia de voz fuera de especificación (Baja probabilidad / Alto impacto): La carga simultánea de GUI + audio + procesamiento de lenguaje natural podría exceder la capacidad del SoC, elevando la latencia de respuesta por encima de los 2 s. Mitigación: definir perfiles de prioridad de procesos (RT scheduling) en el kernel Linux desde la etapa de integración de software.

R-05 — Complejidad de cumplimiento normativo (Alta probabilidad / Medio impacto): Las pruebas de certificación según IEC 62368-1 y ETSI EN 303 645 pueden revelar no conformidades que requieran revisiones de hardware. Mitigación: involucrar un laboratorio de pruebas desde la fase de prototipo.

9 Supuestos, Riesgos y Decisiones Abiertas

## 9.3. Decisiones Abiertas

D-01: Modelo específico del SoC — condicionará el número de capas de la PCB (4 vs. 6) y el tipo de encapsulado (BGA vs. QFP).

D-02: Tipo de micrófonos (PDM digital vs. analógico con ADC externo) — afecta la complejidad del ruteo y los recursos del SoC.

D-03: Estrategia de integración del SoC (SoM vs. chip-down) — impacta directamente el tiempo de desarrollo y el costo de manufactura.

D-04: Protocolos de domótica soportados por el cliente IP (Matter, Zigbee, HomeKit, etc.) — determinará los requisitos de procesamiento del stack de red y posiblemente añadirá hardware adicional (módulo Zigbee/Thread).

D-05: Mecanismo de implementación del Secure Element — TrustZone integrado en el SoC vs. IC dedicado (ej. ATECC608B) — con implicaciones en costo, área de PCB y garantías de seguridad.

# 10 Conclusiones

El presente documento ha cumplido con el propósito definido en la guía del Entregable 2: transformar los requisitos del asistente de voz ALMA en una base técnica sólida para el diseño detallado posterior.

Las principales conclusiones del trabajo son:

1. Trazabilidad completa: Los diez requisitos del Entregable 1 fueron clasificados correctamente en categorías HW, SW o Mixto, con justificación técnica en cada caso. La clasificación revela que la mayoría de los requisitos funcionales son de naturaleza mixta, lo que anticipa la necesidad de una colaboración estrecha entre los equipos de hardware y software.
2. Viabilidad técnica confirmada: El presupuesto energético consolidado (19 W estimados) es viable con una fuente de 12V/2A (24 W), con margen del 20 %. La densidad de periféricos requerida (MIPI DSI, I2S, PDM, I2C, SDIO) es compatible con SoCs ARM64 industriales de amplia disponibilidad.
3. Conflictos de diseño identificados y gestionables: Los principales conflictos detectados (audio de alta potencia vs. sensibilidad de micrófonos, brillo de pantalla vs. disipación térmica) tienen soluciones conocidas de ingeniería (aislamiento mecánico, control adaptivo de brillo) que serán implementadas en el diseño detallado.
4. Arquitectura modular coherente: La partición en seis subsistemas (SPCA, SAA, SIVI, SGE, SCR y SPSF) surgió naturalmente del análisis de interdependencias y no de una decisión arbitraria. Esta modularidad facilitará el desarrollo paralelo y la verificación independiente de cada bloque.
5. Criterios de verificación accionables: Los criterios de aceptación refinados son ahora cuantificables y asociados a métodos de prueba específicos, lo que permitirá una validación objetiva del producto en fases posteriores.
6. Decisiones abiertas registradas: Se han identificado cinco decisiones pendientes de alto impacto (selección del SoC, tipo de micrófonos, estrategia de integración, protocolos de domótica y elemento de seguridad). Su resolución en la siguiente etapa del proyecto condicionará aspectos críticos del diseño de PCB y del stack de software.

El equipo concluye que ALMA es un producto técnicamente realizable dentro de los parámetros definidos, y que las decisiones tomadas en este documento proporcionan una base consistente para iniciar la fase de diseño de esquemáticos y selección definitiva de componentes.

# Bibliografía

[1] Universidad de Antioquia, Laboratorio de Diseño de Productos Electrónicos. Guía de desarrollo – Entregable 2: Documento de especificaciones técnicas del producto. Medellín, Colombia, 2026.
[2] Universidad de Antioquia, Laboratorio de Diseño de Productos Electrónicos. Proyecto Final – Asistente de Voz ALMA. Medellín, Colombia, 2026.
[3] International Electrotechnical Commission (IEC). IEC 62368-1: Audio/video, information and communication technology equipment – Part 1: Safety requirements. Tercera edición, 2018.
[4] European Telecommunications Standards Institute (ETSI). ETSI EN 303 645 V2.1.1: Cyber Security for Consumer Internet of Things: Baseline Requirements. 2020.
