juanforozco/Proyecto_Final_DPE/main.tex

% ******************
% Document Class Definition
% ******************
\documentclass[%
	paper=a4,				% paper size
	twoside=false,				% onesite or twoside printing
	parskip=half,				% spacing value para párrafos (ajustado de 8mm para KOMA-Script)
	chapterprefix=false, 		% prefix for chapter marks
	10pt,						% font size
	headings=normal,			% size of headings
	bibliography=totoc,			% include bib in toc
	listof=totoc,				% include listof entries in toc
	titlepage=on,				% own page for each title page
	captions=tableabove,		% display table captions above the float env
	draft=false,				% value for draft version
]{scrbook}%

% --- Paquetes de Estilo y Gráficos ---
\usepackage[utf8]{inputenc}
\usepackage[spanish, es-tabla]{babel}
\usepackage[letterpaper, left=2cm, right=2cm, top=3cm, bottom=3cm]{geometry}
\usepackage{graphicx}
\usepackage{float}
\usepackage{subcaption}
\usepackage[table,xcdraw,dvipsnames]{xcolor}
\usepackage{ragged2e}
\usepackage[absolute,overlay]{textpos}

% --- Matemáticas y Algoritmos ---
\usepackage{amsmath,amsfonts}
\usepackage[linesnumbered,ruled,vlined]{algorithm2e}

% --- Tablas y Listas ---
\usepackage{tabularx}
\usepackage{multirow,array}
\usepackage{longtable}
\usepackage[shortlabels]{enumitem}

% --- Código y Texto de Relleno ---
\usepackage{listings}
% \usepackage{minted} % Comentado por defecto si no compilas con -shell-escape
\usepackage{blindtext}
\usepackage{multicol}
\usepackage{comment}

% --- Configuración de Hipervínculos ---
\usepackage{hyperref}
\hypersetup{
	colorlinks=true,
    citecolor=black,
    filecolor=black,
    linkcolor=black,
    urlcolor=black
}
\urlstyle{same}

% --- Bibliografía ---
\usepackage[square,numbers,sectionbib]{natbib}
\usepackage[sectionbib]{chapterbib}

% --- Configuraciones Personalizadas ---
\lstset{
    breaklines=true,
	basicstyle=\footnotesize\ttfamily,
	xleftmargin=.0in,
	xrightmargin=.0in
} 

% Numeración personalizada solicitada
\renewcommand{\theequation}{\thechapter-\arabic{equation}}
\renewcommand{\thefigure}{\textbf{\thechapter-\arabic{figure}}}
\renewcommand{\thetable}{\textbf{\thechapter-\arabic{table}}}

\renewcommand{\chaptermark}[1]{\markboth{\thechapter\; #1}{}}
\renewcommand{\sectionmark}[1]{\markright{\thesection\; #1}}

% *****************************************************************************
% CUERPO DEL DOCUMENTO
% *****************************************************************************
\begin{document}

% Portada
\begin{titlepage}
    \centering
    \vspace*{2cm}
    {\Large \textbf{Diseño de Productos Electronicos}} \\[1cm] % Puedes reemplazar esto
    {\Huge \textbf{Entregable 1: Documento de Requisitos}} \\[0.5cm]
    {\LARGE \textbf{Producto ALMA}} \\[1.5cm]
    {\Large Miguel Angel Alvarez Guzman} \\[0.5cm]
    {\Large Juan Felipe Orozco Londoño} \\[0.5cm]
    {\Large Carlos Augusto Quintero Velez} \\[0.5cm]
    {\large Grupo: 04} \\[2cm] % Reemplazar con el grupo real
    \vfill
    {\large \today}
\end{titlepage}

\tableofcontents
\listoftables

\chapter{Introducción}

\section{Propósito del entregable}
El presente documento constituye el primer entregable del proyecto final, cuyo propósito es definir de forma explícita, completa y verificable los requisitos técnicos del producto ALMA. Este dispositivo se concibe como un altavoz inteligente de mesa que se ejecuta en Linux bajo una arquitectura ARM64.

A través de este documento, se establece la base técnica fundamental para las posteriores fases de diseño de hardware, permitiendo traducir las necesidades del producto en especificaciones que aseguren la coherencia de la arquitectura y la viabilidad de la implementación antes de iniciar el diseño físico. 

Para lograr este objetivo, el documento reúne una lista exhaustiva de requisitos organizados en las siguientes categorías:
\begin{itemize}
    \item \textbf{Requisitos funcionales:} Relacionados con las capacidades de interacción por voz, reproducción de audio y control de red.
    \item \textbf{Requisitos no funcionales:} Relacionados con el desempeño, persistencia de datos y privacidad.
    \item \textbf{Requisitos ambientales:} Condiciones del entorno de operación.
    \item \textbf{Requisitos de interfaz gráfica (GUI):} Asociados a la pantalla táctil a color y visualización de estados.
    \item \textbf{Requisitos de estándares esenciales:} Derivados de normativas aplicables en seguridad eléctrica, compatibilidad electromagnética (EMC/EMI), radio y ciberseguridad.
\end{itemize}

Cada uno de los requisitos aquí expuestos ha sido redactado en un lenguaje técnico e incluye criterios de aceptación claros y las pruebas o métodos necesarios para verificar su cumplimiento[cite: 135]. Cabe destacar que, en esta etapa, el foco se mantiene en la definición del comportamiento esperado del sistema y no en la selección de referencias específicas de componentes o implementaciones detalladas de hardware/software[cite: 129, 140].
\chapter{Alcance del Producto}

\section{Descripción General}
ALMA se define como un altavoz inteligente de mesa diseñado para entornos domésticos u oficinas. El sistema opera sobre una plataforma de hardware con arquitectura ARM64 ejecutando un sistema operativo basado en Linux, compatible con el stack de OpenVoiceOS (OVOS). El producto combina procesamiento de voz a distancia, una ruta de audio de alta fidelidad, una interfaz visual táctil y elementos de iluminación ambiental para proporcionar una experiencia de usuario integral.

\section{Funcionalidades y Características Incluidas}
El alcance técnico del producto ALMA para este diseño contempla los siguientes elementos:
\begin{itemize}
    \item \textbf{Interacción por voz:} Capacidad de captura de comandos de voz a distancia y respuesta mediante síntesis de voz o retroalimentación visual.
    \item \textbf{Sistema de Audio HD:} Reproducción de audio a través de un códec externo por interfaz I2S, con soporte técnico para audio de alta definición (hasta 24-bit/96 kHz).
    \item \textbf{Interfaz Gráfica (GUI):} Pantalla táctil a color conectada mediante MIPI DSI para el control local, visualización de estados del sistema y configuración de red.
    \item \textbf{Control de Dispositivos Externos:} Funcionalidad de cliente IP en red local para interactuar con otros dispositivos inteligentes bajo mecanismos de seguridad.
    \item \textbf{Persistencia de Datos:} Capacidad de conservar configuraciones críticas (red, volumen, preferencias) y estados del sistema tras una desconexión eléctrica accidental.
    \item \textbf{Interfaz Física y Privacidad:} Inclusión de botones físicos para control de volumen y un interruptor físico (hardware-level) para el silenciado de micrófonos con indicador visual claro.
    \item \textbf{Iluminación Ambiental:} Sistema de iluminación RGB integrado para indicar estados y mejorar la estética del dispositivo.
\end{itemize}

\section{Exclusiones y Limitaciones}
Para efectos de la presente etapa del proyecto, se consideran fuera del alcance los siguientes puntos:
\begin{itemize}
    \item \textbf{Implementación de Software/Firmware:} El alcance se limita a la definición de la arquitectura lógica y la interacción hardware-software, pero no incluye la programación o desarrollo del código fuente.
    \item \textbf{Hub de Radio Específico:} ALMA no actuará como un concentrador (hub) directo para protocolos Zigbee, Thread o Matter; su comunicación con estos ecosistemas se realizará exclusivamente vía IP a través de la red local.
    \item \textbf{Certificaciones Formales:} Aunque el diseño se basa en estándares esenciales (EMC, seguridad eléctrica, ciberseguridad), no se incluye la realización de ensayos de laboratorio ni trámites de certificación comercial.
    \item \textbf{Selección de Componentes Finales:} En esta fase de requisitos, no se definen marcas ni números de parte comerciales específicos, priorizando el comportamiento y desempeño esperado del sistema.
\end{itemize}

\chapter{Metodología de Construcción de Requisitos}

Para la elaboración y consolidación de la lista de requisitos técnicos del producto ALMA, el equipo de trabajo siguió un enfoque estructurado y sistemático, alineado con las directrices de diseño del curso \cite{guia_entregable1}. El proceso metodológico se desarrolló a través de las siguientes fases:

\begin{enumerate}
    \item \textbf{Análisis de la descripción del producto:} Se realizó una lectura exhaustiva del documento base del proyecto final \cite{guia_proyecto_final} para extraer todas las necesidades explícitas e implícitas del asistente de voz ALMA. Esto incluyó la identificación de la arquitectura base (ARM64 ejecutando Linux), la necesidad de un códec de audio externo por I2S y el requerimiento de una pantalla conectada por MIPI DSI.
    
    \item \textbf{Clasificación y categorización:} Las necesidades identificadas se organizaron en las cinco categorías exigidas: funcionales, no funcionales, ambientales, de interfaz gráfica (GUI) y asociadas a estándares esenciales.
    
    \item \textbf{Revisión de estándares y normativas esenciales:} Se consultaron marcos regulatorios clave para derivar requisitos verificables que aseguren la viabilidad comercial del diseño. Para la seguridad eléctrica de equipos de audio/video y tecnología de la información, se utilizó como referencia la norma IEC 62368-1 \cite{iec62368}. Asimismo, para establecer un \textit{baseline} de ciberseguridad en dispositivos IoT de consumo, se revisaron los lineamientos de la norma ETSI EN 303 645 \cite{etsi303645}.
    
    \item \textbf{Revisión de productos similares:} Se analizaron las especificaciones de altavoces inteligentes comerciales de referencia para identificar exigencias razonables de desempeño. Esto permitió establecer parámetros numéricos objetivos, como tiempos de respuesta aceptables, rangos de temperatura de operación y niveles de tolerancia de ruido para los micrófonos.
    
    \item \textbf{Discusión interna y consolidación final:} El equipo realizó sesiones de revisión cruzada para depurar la versión inicial del listado. Durante este proceso, se eliminaron ambigüedades, se fusionaron requisitos redundantes y se verificó que no existieran contradicciones. Finalmente, a cada requisito se le asignó un identificador único, un criterio de aceptación medible y un método de verificación técnico comprobable (inspección, análisis, cálculo, simulación o prueba funcional).
\end{enumerate}
\chapter{Lista de Requisitos de Hardware (Diseño de PCB)}

En este capítulo se definen los requisitos técnicos del producto ALMA orientados exclusivamente al diseño físico de la placa de circuito impreso (PCB). Estos requerimientos han sido extraídos de las necesidades de arquitectura \cite{guia_proyecto_final} y las mejores prácticas de diseño para integridad de señal y compatibilidad electromagnética \cite{iec62368}.

\begin{table}[H]
    \caption{Lista de Requisitos Orientados al Diseño de PCB}
    \centering
    \renewcommand{\arraystretch}{1.5}
    \begin{tabularx}{\textwidth}{|>{\hsize=0.15\hsize\linewidth=\hsize}X|
                                   >{\hsize=0.15\hsize\linewidth=\hsize}X|
                                   >{\hsize=0.4\hsize\linewidth=\hsize}X|
                                   >{\hsize=0.3\hsize\linewidth=\hsize}X|}
        \hline
        \rowcolor[HTML]{EFEFEF} 
        \textbf{ID} & \textbf{Tipo} & \textbf{Requisito} & \textbf{Justificación} \\ \hline
        
        REQ-F01 & Funcional & El diseño de la PCB debe incluir el enrutamiento de un bus I2S entre el SoC ARM64 y el códec de audio, aplicando técnicas de \textit{length matching} para las señales de reloj y datos. & Garantiza la integridad de la señal para la reproducción de audio de alta resolución sin pérdida de sincronía \cite{guia_proyecto_final}. \\ \hline
        
        REQ-F02 & Funcional & El diseño debe implementar pistas de alimentación (Power Nets) con un ancho calculado para soportar la corriente máxima requerida por el SoC y los periféricos de audio, limitando el incremento de temperatura. & Asegura una distribución de potencia (PDN) estable y evita el sobrecalentamiento de las pistas por alta densidad de corriente. \\ \hline

        REQ-NF01 & No Funcional & El esquemático y layout deben incorporar un corte físico en la topología de las señales (nets) de los micrófonos, interrumpiendo eléctricamente la pista a través de un switch físico. & Cumple con el requisito de privacidad a nivel de hardware estipulado para el asistente de voz \cite{guia_proyecto_final}. \\ \hline
        
        REQ-G01 & GUI & El enrutamiento de la interfaz de pantalla MIPI DSI debe realizarse mediante pares diferenciales con un perfil de impedancia controlada de $100\,\Omega \pm 10\%$. & Es un requisito eléctrico estricto del protocolo MIPI para evitar reflexiones en señales de alta frecuencia \cite{guia_proyecto_final}. \\ \hline
        
        REQ-A01 & Ambiental & El layout debe incluir planos de cobre dedicados (GND) y matrices de vías térmicas (\textit{thermal vias}) ubicadas directamente debajo del SoC y los integrados de potencia. & Maximiza la disipación térmica hacia las capas internas de la placa, asegurando la operación dentro del rango de temperatura seguro. \\ \hline
        
        REQ-E01 & Estándar & La PCB debe disponer de un plano de tierra (GND) sólido, sin cortes bajo señales de alta velocidad, y condensadores de desacople ubicados lo más cerca posible de los pines de alimentación de cada IC. & Minimiza la emisión de ruido electromagnético (EMI) y protege contra interferencias externas, base normativa aplicable a equipos electrónicos \cite{iec62368}. \\ \hline

    \end{tabularx}
\end{table}

\chapter{Matriz de Verificación en Altium Designer}

Este capítulo presenta los métodos de comprobación que se aplicarán directamente sobre la plataforma de diseño asistido por computadora (CAD) Altium Designer para asegurar que el diseño esquemático y el layout cumplen con los requerimientos estipulados en el capítulo anterior. No se contemplan pruebas de laboratorio físico en esta etapa.

\begin{table}[H]
    \caption{Matriz de Verificación basada en Herramientas de Altium Designer}
    \centering
    \renewcommand{\arraystretch}{1.5}
    \begin{tabularx}{\textwidth}{|>{\hsize=0.15\hsize\linewidth=\hsize}X|
                                   >{\hsize=0.45\hsize\linewidth=\hsize}X|
                                   >{\hsize=0.4\hsize\linewidth=\hsize}X|}
        \hline
        \rowcolor[HTML]{EFEFEF} 
        \textbf{ID Req. Asociado} & \textbf{Criterio de Aceptación en el Software} & \textbf{Método de Verificación en Altium} \\ \hline
        
        REQ-F01 & El panel de \textit{PCB Rules and Violations} reporta 0 errores en las reglas de tolerancia de longitud para el Net Class de la interfaz I2S. & Ejecución del \textbf{DRC (Design Rule Check)} para evaluar las reglas de \textit{Matched Lengths}. \\ \hline
        
        REQ-F02 & El ancho de las pistas de la red de alimentación ($V_{CC}$) cumple con los requisitos del estándar IPC-2152 configurados en las reglas de ruteo. & Revisión mediante \textbf{DRC (\textit{Width Constraint})} e inspección visual interactiva de polígonos de cobre. \\ \hline

        REQ-NF01 & Al rastrear la conectividad del net de los micrófonos con la herramienta \textit{Cross Probe}, la conexión se muestra físicamente dividida en los terminales del componente Switch. & Análisis lógico mediante el \textbf{ERC (Electrical Rule Check)} e inspección del esquemático y layout 2D. \\ \hline
        
        REQ-G01 & El perfil calculado por el \textit{Impedance Profile} del Layer Stack Manager para los pares MIPI indica un valor nominal de $100\,\Omega$. & Verificación analítica mediante la calculadora de impedancia del \textbf{Layer Stack Manager} y \textbf{DRC (\textit{Differential Pairs Routing})}. \\ \hline
        
        REQ-A01 & El diseño en vista 2D y 3D muestra arreglos de vías en los \textit{pads} térmicos de los integrados principales, conectados al plano GND interno. & \textbf{Inspección visual y modelado 3D} dentro del entorno de PCB de Altium. \\ \hline
        
        REQ-E01 & El flujo de corriente de retorno no atraviesa áreas vacías (\textit{splits}) en las capas de GND subyacentes a las pistas de alta frecuencia. & Inspección visual con resaltado de redes (\textit{Highlight Nets}) y análisis del \textbf{DRC de polígonos (\textit{Unpoured Polygon Pours})}. \\ \hline

    \end{tabularx}
\end{table}

\chapter{Observaciones y Conclusiones}

\section{Observaciones, supuestos o vacíos identificados}
Durante esta fase de definición de requisitos orientados al diseño de la PCB, se han identificado las siguientes incertidumbres técnicas y supuestos que deberán resolverse en la próxima entrega (diseño esquemático):
\begin{itemize}
    \item \textbf{Definición del Stack-up:} Se asume que, dada la complejidad del enrutamiento de señales de alta velocidad (interfaz MIPI DSI) y el uso de un SoC con arquitectura ARM64, la placa requerirá un \textit{stack-up} mínimo de 4 a 6 capas. El perfil exacto de capas y dieléctricos está sujeto a los cálculos finales de impedancia controlada y a las capacidades del fabricante.
    \item \textbf{Selección de Componentes Específicos:} Al estar en una etapa de definición conceptual, aún no se han fijado los números de parte comerciales para el SoC, el códec de audio I2S ni la memoria. La elección de estos encapsulados (\textit{footprints}) definirá las reglas de diseño (DRC) definitivas, como el ancho mínimo de pista (\textit{track}) y espacio (\textit{clearance}) para fan-out de componentes BGA.
    \item \textbf{Gestión Térmica:} Se supone que la disipación pasiva a través de los planos de cobre y vías térmicas será suficiente. Sin embargo, este vacío deberá corroborarse mediante cálculos de disipación de potencia una vez se consolide el árbol de potencia (\textit{Power Tree}).
\end{itemize}

\section{Conclusiones}
Este primer entregable ha permitido establecer una base técnica sólida y estructurada, orientada exclusivamente al diseño físico del hardware para el producto ALMA. Al traducir las necesidades generales del asistente de voz en especificaciones concretas de trazado de PCB (integridad de señal, distribución de potencia y mitigación de EMI) fundamentadas en normativas \cite{iec62368}, se mitigan los riesgos de diseño temprano.

Asimismo, al vincular cada requisito con una matriz de verificación basada enteramente en las herramientas de validación de Altium Designer (DRC, ERC, Layer Stack Manager y visualización 3D), el equipo de diseño cuenta ahora con una hoja de ruta objetiva y medible. 

Finalmente, es importante destacar que los criterios de selección y la formulación de todos los requisitos técnicos aquí expuestos fueron basados en su casi totalidad en las especificaciones y lineamientos detallados en la guía oficial del proyecto \cite{guia_proyecto_final}. Esto garantiza una alineación estricta con los objetivos del curso, asegurando que la transición hacia la captura esquemática y el \textit{layout} se realice bajo parámetros viables, claros y directamente trazables a las necesidades del producto.
% *****************************************************************************
% BIBLIOGRAFÍA
% *****************************************************************************
\renewcommand{\bibname}{Referencias} % Cambia el nombre del capítulo a "Referencias"
\begin{thebibliography}{99}

\bibitem{guia_entregable1} 
Universidad de Antioquia, Laboratorio de Diseño de Productos Electrónicos. \textit{Guía de desarrollo - Entregable 1: Documento de requisitos del producto}. Medellín, Colombia, 2026.

\bibitem{guia_proyecto_final} 
Universidad de Antioquia, Laboratorio de Diseño de Productos Electrónicos. \textit{Proyecto Final - Asistente de Voz ALMA}. Medellín, Colombia, 2026.

\bibitem{iec62368} 
International Electrotechnical Commission (IEC). \textit{IEC 62368-1: Audio/video, information and communication technology equipment - Part 1: Safety requirements}. 

\bibitem{etsi303645} 
European Telecommunications Standards Institute (ETSI). \textit{ETSI EN 303 645: Cyber Security for Consumer Internet of Things: Baseline Requirements}.

\end{thebibliography}
\end{document}
