juanforozco/Proyecto_Final_DPE/main.pdf

## Diseño de Productos Electronicos

# Entregable 1: Documento de Requisitos

# Producto ALMA

## Miguel Angel Alvarez Guzman

## Juan Felipe Orozco Londoño

## Carlos Augusto Quintero Velez

Grupo: 04

12 de junio de 2026

# Índice general

Índice de tablas | 3
1 Introducción | 4
2 Alcance del Producto | 5
3 Metodología de Construcción de Requisitos | 7
4 Lista de Requisitos de Hardware (Diseño de PCB) | 8
5 Matriz de Verificación en Altium Designer | 9
6 Observaciones y Conclusiones | 10
Referencias | 11

# Índice de tablas

# 1 Introducción

## 1.1. Propósito del entregable

El presente documento constituye el primer entregable del proyecto final, cuyo propósito es definir de forma explícita, completa y verificable los requisitos técnicos del producto ALMA. Este dispositivo se concibe como un altavoz inteligente de mesa que se ejecuta en Linux bajo una arquitectura ARM64.

A través de este documento, se establece la base técnica fundamental para las posteriores fases de diseño de hardware, permitiendo traducir las necesidades del producto en especificaciones que aseguren la coherencia de la arquitectura y la viabilidad de la implementación antes de iniciar el diseño físico.

Para lograr este objetivo, el documento reúne una lista exhaustiva de requisitos organizados en las siguientes categorías:

Requisitos funcionales: Relacionados con las capacidades de interacción por voz, reproducción de audio y control de red.

Requisitos no funcionales: Relacionados con el desempeño, persistencia de datos y privacidad.

Requisitos ambientales: Condiciones del entorno de operación.

Requisitos de interfaz gráfica (GUI): Asociados a la pantalla táctil a color y visualización de estados.

Requisitos de estándares esenciales: Derivados de normativas aplicables en seguridad eléctrica, compatibilidad electromagnética (EMC/EMI), radio y ciberseguridad.

Cada uno de los requisitos aquí expuestos ha sido redactado en un lenguaje técnico e incluye criterios de aceptación claros y las pruebas o métodos necesarios para verificar su cumplimiento[cite: 135]. Cabe destacar que, en esta etapa, el foco se mantiene en la definición del comportamiento esperado del sistema y no en la selección de referencias específicas de componentes o implementaciones detalladas de hardware/software[cite: 129, 140].

# 2 Alcance del Producto

## 2.1. Descripción General

ALMA se define como un altavoz inteligente de mesa diseñado para entornos domésticos u oficinas. El sistema opera sobre una plataforma de hardware con arquitectura ARM64 ejecutando un sistema operativo basado en Linux, compatible con el stack de OpenVoiceOS (OVOS). El producto combina procesamiento de voz a distancia, una ruta de audio de alta fidelidad, una interfaz visual táctil y elementos de iluminación ambiental para proporcionar una experiencia de usuario integral.

## 2.2. Funcionalidades y Características Incluidas

El alcance técnico del producto ALMA para este diseño contempla los siguientes elementos:

Interacción por voz: Capacidad de captura de comandos de voz a distancia y respuesta mediante síntesis de voz o retroalimentación visual.

Sistema de Audio HD: Reproducción de audio a través de un códec externo por interfaz I2S, con soporte técnico para audio de alta definición (hasta 24-bit/96 kHz).

Interfaz Gráfica (GUI): Pantalla táctil a color conectada mediante MIPI DSI para el control local, visualización de estados del sistema y configuración de red.

Control de Dispositivos Externos: Funcionalidad de cliente IP en red local para interactuar con otros dispositivos inteligentes bajo mecanismos de seguridad.

Persistencia de Datos: Capacidad de conservar configuraciones críticas (red, volumen, preferencias) y estados del sistema tras una desconexión eléctrica accidental.

Interfaz Física y Privacidad: Inclusión de botones físicos para control de volumen y un interruptor físico (hardware-level) para el silenciado de micrófonos con indicador visual claro.

Iluminación Ambiental: Sistema de iluminación RGB integrado para indicar estados y mejorar la estética del dispositivo.

## 2.3. Exclusiones y Limitaciones

Para efectos de la presente etapa del proyecto, se consideran fuera del alcance los siguientes puntos:

Implementación de Software/Firmware: El alcance se limita a la definición de la arquitectura lógica y la interacción hardware-software, pero no incluye la programación o desarrollo del código fuente.

Hub de Radio Específico: ALMA no actuará como un concentrador (hub) directo para protocolos Zigbee, Thread o Matter; su comunicación con estos ecosistemas se realizará exclusivamente vía IP a través de la red local.

2.3 Exclusiones y Limitaciones

Certificaciones Formales: Aunque el diseño se basa en estándares esenciales (EMC, seguridad eléctrica, ciberseguridad), no se incluye la realización de ensayos de laboratorio ni trámites de certificación comercial.

Selección de Componentes Finales: En esta fase de requisitos, no se definen marcas ni números de parte comerciales específicos, priorizando el comportamiento y desempeño esperado del sistema.

# 3 Metodología de Construcción de Requisitos

Para la elaboración y consolidación de la lista de requisitos técnicos del producto ALMA, el equipo de trabajo siguió un enfoque estructurado y sistemático, alineado con las directrices de diseño del curso [1]. El proceso metodológico se desarrolló a través de las siguientes fases:

1. Análisis de la descripción del producto: Se realizó una lectura exhaustiva del documento base del proyecto final [2] para extraer todas las necesidades explícitas e implícitas del asistente de voz ALMA. Esto incluyó la identificación de la arquitectura base (ARM64 ejecutando Linux), la necesidad de un códec de audio externo por I2S y el requerimiento de una pantalla conectada por MIPI DSI.
2. Clasificación y categorización: Las necesidades identificadas se organizaron en las cinco categorías exigidas: funcionales, no funcionales, ambientales, de interfaz gráfica (GUI) y asociadas a estándares esenciales.
3. Revisión de estándares y normativas esenciales: Se consultaron marcos regulatorios clave para derivar requisitos verificables que aseguren la viabilidad comercial del diseño. Para la seguridad eléctrica de equipos de audio/video y tecnología de la información, se utilizó como referencia la norma IEC 62368-1 [3]. Asimismo, para establecer un baseline de ciberseguridad en dispositivos IoT de consumo, se revisaron los lineamientos de la norma ETSI EN 303 645 [4].
4. Revisión de productos similares: Se analizaron las especificaciones de altavoces inteligentes comerciales de referencia para identificar exigencias razonables de desempeño. Esto permitió establecer parámetros numéricos objetivos, como tiempos de respuesta aceptables, rangos de temperatura de operación y niveles de tolerancia de ruido para los micrófonos.
5. Discusión interna y consolidación final: El equipo realizó sesiones de revisión cruzada para depurar la versión inicial del listado. Durante este proceso, se eliminaron ambigüedades, se fusionaron requisitos redundantes y se verificó que no existieran contradicciones. Finalmente, a cada requisito se le asignó un identificador único, un criterio de aceptación medible y un método de verificación técnico comprobable (inspección, análisis, cálculo, simulación o prueba funcional).

# 4 Lista de Requisitos de Hardware (Diseño de PCB)

En este capítulo se definen los requisitos técnicos del producto ALMA orientados exclusivamente al diseño físico de la placa de circuito impreso (PCB). Estos requerimientos han sido extraídos de las necesidades de arquitectura [2] y las mejores prácticas de diseño para integridad de señal y compatibilidad electromagnética [3].

Tabla 4-1: Lista de Requisitos Orientados al Diseño de PCB

ID | Tipo | Requisito | Justificación
REQ-F01 | Funcional | El diseño de la PCB debe incluir el en-rutamiento de un bus I2S entre el SoC ARM64 y el códec de audio, aplican-do técnicas de length matching para las señales de reloj y datos. | Garantiza la integridad de la señal para la reproducción de audio de alta resolución sin pérdida de sincronía [2].
REQ-F02 | Funcional | El diseño debe implementar pistas de ali-mentación (Power Nets) con un ancho cal-culado para soportar la corriente máxima requerida por el SoC y los periféricos de audio, limitando el incremento de tempe-ratura. | Asegura una distribución de potencia (PDN) estable y evi-ta el sobrecalentamiento de las pistas por alta densidad de co-rriente.
REQ-NF01 | No Funcional | El esquemático y layout deben incorpo-rar un corte físico en la topología de las señales (nets) de los micrófonos, interrum-piendo eléctricamente la pista a través de un switch físico. | Cumple con el requisito de pri-vacidad a nivel de hardware es-tipulado para el asistente de voz [2].
REQ-G01 | GUI | El enrutamiento de la interfaz de pantalla MIPI DSI debe realizarse mediante pares diferenciales con un perfil de impedancia controlada de 100 Ω ± 10 %. | Es un requisito eléctrico estric-to del protocolo MIPI para evi-tar reflexiones en señales de al-ta frecuencia [2].
REQ-A01 | Ambiental | El layout debe incluir planos de cobre de-dicados (GND) y matrices de vías térmi-cas (thermal vias) ubicadas directamente debajo del SoC y los integrados de poten-cia. | Maximiza la disipación térmica hacia las capas internas de la placa, asegurando la operación dentro del rango de temperatu-ra seguro.
REQ-E01 | Estándar | La PCB debe disponer de un plano de tie-rra (GND) sólido, sin cortes bajo señales de alta velocidad, y condensadores de des-acople ubicados lo más cerca posible de los pines de alimentación de cada IC. | Minimiza la emisión de ruido electromagnético (EMI) y pro-tege contra interferencias ex-ternas, base normativa aplica-ble a equipos electrónicos [3].

# 5 Matriz de Verificación en Altium Designer

Este capítulo presenta los métodos de comprobación que se aplicarán directamente sobre la plataforma de diseño asistido por computadora (CAD) Altium Designer para asegurar que el diseño esquemático y el layout cumplen con los requerimientos estipulados en el capítulo anterior. No se contemplan pruebas de laboratorio físico en esta etapa.

Tabla 5-1: Matriz de Verificación basada en Herramientas de Altium Designer

ID Req. Aso-ciado | Criterio de Aceptación en el Software | Método de Verificación en Altium
REQ-F01 | El panel de PCB Rules and Violations reporta 0 errores en las reglas de tolerancia de longitud para el Net Class de la interfaz I2S. | Ejecución del DRC (Design Rule Check) para evaluar las reglas de Matched Lengths.
REQ-F02 | El ancho de las pistas de la red de alimentación (VCC ) cumple con los requisitos del estándar IPC-2152 configurados en las reglas de ruteo. | Revisión mediante DRC (Width Cons-traint) e inspección visual interactiva de polígonos de cobre.
REQ-NF01 | Al rastrear la conectividad del net de los micrófonos con la herramienta Cross Probe, la conexión se muestra físicamente dividida en los terminales del componente Switch. | Análisis lógico mediante el ERC (Elec-trical Rule Check) e inspección del es-quemático y layout 2D.
REQ-G01 | El perfil calculado por el Impedance Profile del Layer Stack Manager para los pares MIPI indica un valor nominal de 100 Ω. | Verificación analítica mediante la calcu-ladora de impedancia del Layer Stack Manager y DRC (Differential Pairs Routing).
REQ-A01 | El diseño en vista 2D y 3D muestra arreglos de vías en los pads térmicos de los integrados prin-cipales, conectados al plano GND interno. | Inspección visual y modelado 3D den-tro del entorno de PCB de Altium.
REQ-E01 | El flujo de corriente de retorno no atraviesa áreas vacías (splits) en las capas de GND subyacentes a las pistas de alta frecuencia. | Inspección visual con resaltado de re-des (Highlight Nets) y análisis del DRC de polígonos (Unpoured Polygon Pours).

# 6 Observaciones y Conclusiones

## 6.1. Observaciones, supuestos o vacíos identificados

Durante esta fase de definición de requisitos orientados al diseño de la PCB, se han identificado las siguientes incertidumbres técnicas y supuestos que deberán resolverse en la próxima entrega (diseño esquemático):

Definición del Stack-up: Se asume que, dada la complejidad del enrutamiento de señales de alta velocidad (interfaz MIPI DSI) y el uso de un SoC con arquitectura ARM64, la placa requerirá un stack-up mínimo de 4 a 6 capas. El perfil exacto de capas y dieléctricos está sujeto a los cálculos finales de impedancia controlada y a las capacidades del fabricante.

Selección de Componentes Específicos: Al estar en una etapa de definición conceptual, aún no se han fijado los números de parte comerciales para el SoC, el códec de audio I2S ni la memoria. La elección de estos encapsulados (footprints) definirá las reglas de diseño (DRC) definitivas, como el ancho mínimo de pista (track) y espacio (clearance) para fan-out de componentes BGA.

Gestión Térmica: Se supone que la disipación pasiva a través de los planos de cobre y vías térmicas será suficiente. Sin embargo, este vacío deberá corroborarse mediante cálculos de disipación de potencia una vez se consolide el árbol de potencia (Power Tree).

## 6.2. Conclusiones

Este primer entregable ha permitido establecer una base técnica sólida y estructurada, orientada exclusivamente al diseño físico del hardware para el producto ALMA. Al traducir las necesidades generales del asistente de voz en especificaciones concretas de trazado de PCB (integridad de señal, distribución de potencia y mitigación de EMI) fundamentadas en normativas [3], se mitigan los riesgos de diseño temprano.

Asimismo, al vincular cada requisito con una matriz de verificación basada enteramente en las herramientas de validación de Altium Designer (DRC, ERC, Layer Stack Manager y visualización 3D), el equipo de diseño cuenta ahora con una hoja de ruta objetiva y medible.

Finalmente, es importante destacar que los criterios de selección y la formulación de todos los requisitos técnicos aquí expuestos fueron basados en su casi totalidad en las especificaciones y lineamientos detallados en la guía oficial del proyecto [2]. Esto garantiza una alineación estricta con los objetivos del curso, asegurando que la transición hacia la captura esquemática y el layout se realice bajo parámetros viables, claros y directamente trazables a las necesidades del producto.

# Referencias

[1] Universidad de Antioquia, Laboratorio de Diseño de Productos Electrónicos. Guía de desarrollo - Entregable 1: Documento de requisitos del producto. Medellín, Colombia, 2026.
[2] Universidad de Antioquia, Laboratorio de Diseño de Productos Electrónicos. Proyecto Final - Asistente de Voz ALMA. Medellín, Colombia, 2026.
[3] International Electrotechnical Commission (IEC). IEC 62368-1: Audio/video, information and communication technology equipment - Part 1: Safety requirements.
[4] European Telecommunications Standards Institute (ETSI). ETSI EN 303 645: Cyber Security for Consumer Internet of Things: Baseline Requirements.
