juanforozco/Proyecto_Final_DPE/Proyecto_Final_Digitales/Project Outputs for Main_Board_Diseño/bom_1000.pdf

Line # | Name | Description | Designator | Revision ID | Revision State | Revision Status | Quantity | Manufacturer 1 | Manufacturer Part Number 1 | Manufacturer Lifecycle 1 | Supplier 1 | Supplier Part Number 1 | Supplier Unit Price 1 | Supplier Subtotal 1
| FUSB302BMPX | Full Speed Programmable USB Power Delivery Controller USB 3.1 3.3V T/R 14-Pin WQFN EP | | CMP-019-00062-1 | Draft | Up to date | | 1 onsemi | FUSB302BMPX | Volume Production | Fmall Co., Limited | FUSB302BMPX | 0.3083 | 308.3
| 146153-0250 | RF ANT 2.4/5GHZ FLAT PATCH 250MM | ANT1, ANT2 | CMP-04721-000005-1 | New From Design | Up to date | | 2 Molex | 146153-0250 | Volume Production | DigiKey | WM12219-ND | 1.55 | 3105.62
| W25Q256JVEIQ | 256M-bit Serial Flash Memory with uniform 4KB sectors and Dual/Quad SPI | B1 | CMP-043-000000-2 | Draft | Up to date | | 1 Winbond | W25Q256JVEIQ | Volume Production | Aztech | W25Q256JVEIQ | 0.71 | 710
| AP6275S | IEEE 802.11ax/ac/a/b/g/n 2x2 WiFi with Bluetooth5.0 Combo Sip Module | B2 | CMP-052-000000-2 | Draft | Up to date | | SparkLAN 1 Communication | AP6275S | Unknown | Techship | AP6275S | 30 | 30000
| Capacitor 100nF +/-20% 50V 0402 | Chip Capacitor, 100nF +/-20%, 50V, 0402, Thickness 0.6 mm | C1, C128, C137 | CMP-001-00067-3 | Draft | Up to date | | 3 Yageo Group | CC0402KRX5R9BB104 | Volume Production | Worldway Electronics | CC0402KRX5R9BB104 | 0.0009 | 2.7
| Capacitor 1nF +/-20% 50V 0402 | Chip Capacitor, 1nF +/-20%, 50V, 0402, Thickness 0.33 mm | C2 | CMP-001-00066-3 | Draft | Up to date | | 1 Yageo Group | CC0402KPX7R9BB102 | Volume Production | Worldway Electronics | CC0402KPX7R9BB102 | 0.0004 | 0.4
| CC0201KRX5R6BB472 | Cap Ceramic 0.0047uF 10V X5R 10% Pad SMD 0201 85C Automotive T/R | C3 | CMP-001-00103-1 | Draft | Up to date | | 1 Yageo Group | CC0201KRX5R6BB472 | Volume Production | Axis Part Limited | CC0201KRX5R6BB472 | 0.0009 | 0.9
| 0201ZD105MAT2A | 10V 1uF X5R ±20% 0201 Multilayer Ceramic Capacitors MLCC - SMD/SMT ROHS | C4 | CMP-001-00105-1 | Draft | Up to date | | 1 KYOCERA AVX | 0201ZD105MAT2A | Volume Production | LCSC | C2177042 | 0.0104 | 10.4
| Capacitor 100nF +/-20% 10V 0402 | Chip Capacitor, 100nF +/-20%, 10V, 0402, Thickness 0.6 mm | C5, C13 | CMP-001-00061-3 | Draft | Up to date | | 2 Yageo Group | CC0402KRX7R6BB104 | Volume Production | Chipsmall Limited | CC0402KRX7R6BB104 | 0.00047 | 0.94
| GRM0335C1H100FA01D | 50V 10pF C0G ±1% 0201 Multilayer Ceramic Capacitors MLCC - SMD/SMT ROHS | C6 | CMP-001-00106-1 | Draft | Up to date | | 1 Murata | GRM0335C1H100FA01D | Volume Production | UnikeyIC | GRM0335C1H100FA01D | 0.0025 | 2.5
| Capacitor 1µF +/-20% 10V 0402 | Chip Capacitor, 1µF +/-20%, 10V, 0402, Thickness 0.6 mm | C7, C8 | CMP-001-00063-3 | Draft | Up to date | | 2 Yageo Group | CC0402KRX5R6BB105 | Volume Production | Axis Part Limited | CC0402KRX5R6BB105 | 0.00121 | 2.42
| C0201C150J3GACTU | 0201 (0603METRIC) Ceramic Capacitor SMD Comm C0G 25V 15PF ±5% C0G NP0 | C9 | CMP-001-00104-1 | Draft | Up to date | | 1 Yageo Group | C0201C150J3GACTU | Volume Production | Schukat | C0201C150J3GAC7867 | 0.0121 | 12.1
| CC0201MRX5R6BB225 | 10V 2.2uF X5R ±20% 0201 Multilayer Ceramic Capacitors MLCC - SMD/SMT ROHS | C10 | CMP-001-00108-1 | Draft | Up to date | | 1 Yageo Group | CC0201MRX5R6BB225 | Volume Production | Unikeyic (ICkey) | CC0201MRX5R6BB225 | 0.0124 | 12.4
| GRM035R60J475ME15J | 0201 4.7 uF 6.3 V ±10 % Tolerance X5R SMT Multilayer Ceramic Chip Capacitor | C11, C12, C130, C138 | CMP-001-00107-1 | Draft | Up to date | | 4 Murata | GRM035R60J475ME15J | Volume Production | Worldway Electronics | GRM035R60J475ME15J | 0.0123 | 49.2
| GRM0335C1H120FA01D | CAP CER 12PF 50V C0G/NP0 0201 / 12 pF ±1% 50V Ceramic Capacitor C0G, NP0 0201 (0603 Metric) | C14, C15 | CMP-001-00114-1 | Draft | Up to date | | 2 Murata | GRM0335C1H120FA01D | Volume Production | UnikeyIC | GRM0335C1H120FA01D | 0.0035 | | 7
| GRM155R60G106ME47 D | CAP CER 10UF 4V X5R 0402 / 10 µF ±20% 4V Ceramic Capacitor X5R 0402 (1005 Metric) | C16, C26, C34, C35, C42, C57, C65, C73, C83, C91, C99, C107, C115, C124 | CMP-001-00109-1 | Draft | Up to date | 14 Murata | | GRM155R60G106ME47D | Volume Production | ODG (Origin Data Global) | GRM155R60G106ME47D | 0.0228 | 319.2
| 0201ZD105MAT2A | 10V 1uF X5R ±20% 0201 Multilayer Ceramic Capacitors MLCC - SMD/SMT ROHS | C17, C18, C32, C33, C37, C44, C45, C46, C80, C131 | CMP-001-00111-1 | Draft | Up to date | 10 KYOCERA AVX | | 0201ZD105MAT2A | Volume Production | ODG (Origin Data Global) | 0201ZD105MAT2A | 0.0056 | 56
| CC0201KRX5R7BB104 | 16V 100nF X5R ±10% 0201 Multilayer Ceramic Capacitors MLCC - SMD/SMT ROHS | C19, C20, C23, C27, C28, C29, C30, C31, C38, C39, C40, C47, C48, C49, C50, C51, C52, C53, C54, C58, C59, C60, C61, C62, C66, C67, C68, C69, C70, C74, C75, C76, C77, C78, C79, C84, C85, C86, C87, C88, C92, C93, C94, C95, C96, C100, C101, C102, C103, C104, C108, C109, C110, C111, C112, C116, C117, C118, C119, C120, C122, C123, C125, C132, C133, C142, C144, C149, C150, C151 | CMP-001-00112-1 | Draft | Up to date | 70 Yageo Group | | CC0201KRX5R7BB104 | Volume Production | Chipsmall Limited | CC0201KRX5R7BB104 | 0.00083 | 58.1
| JMK105BBJ475MVHF | 6.3V 4.7uF X5R ±20% 0402 Multilayer Ceramic Capacitors MLCC - SMD/SMT ROHS | C21, C22, C36, C43 | CMP-001-00110-1 | Draft | Up to date | | 4 TAIYO YUDEN | JMK105BBJ475MVHF | Volume Production | Unikeyic (ICkey) | JMK105BBJ475MVHF | 0.008 | 32
| GRM186R60J226ME15D | 6.3V 22uF X5R ±20% 0603 Multilayer Ceramic Capacitors MLCC - SMD/SMT ROHS | C24, C25, C41, C55, C56, C63, C64, C71, C72, C81, C82, C89, C90, C97, C98, C105, C106, C113, C114 | CMP-001-00097-1 | Draft | Up to date | 19 Murata | | GRM186R60J226ME15D | Volume Production | Bettlink | GRM186R60J226ME15D | 0.04121 | 782.99
| CC0201MRX5R6BB225 | 10V 2.2uF X5R ±20% 0201 Multilayer Ceramic Capacitors MLCC - SMD/SMT ROHS | C121 | CMP-001-00115-1 | Draft | Up to date | | 1 Yageo Group | CC0201MRX5R6BB225 | Volume Production | Unikeyic (ICkey) | CC0201MRX5R6BB225 | 0.0124 | 12.4
| GRM0335C1E220FA01D | 25V 22pF C0G ±1% 0201 Multilayer Ceramic Capacitors MLCC - SMD/SMT ROHS | C126, C127 | CMP-001-00102-1 | Draft | Up to date | | 2 Murata | GRM0335C1E220FA01D | Volume Production | Axis Part Limited | GRM0335C1E220FA01D | 0.0039 | 7.8
| Capacitor 10µF +/-40% 6.3V 0402 | Chip Capacitor, 10µF +/-40%, 6.3V, 0402, Thickness 0.6 mm | C129, C141, C143 | CMP-001-00074-3 | Draft | Up to date | | 3 Murata | GRM155R60J106ME15D | Volume Production | Worldway Electronics | GRM155R60J106ME15D | 0.0105 | 31.5
| Capacitor 10µF +/-20% 10V 0603 | Chip Capacitor, 10µF +/-20%, 10V, 0603, Thickness 1 mm | C134, C135, C136, C145, C146, C148 | CMP-001-00075-4 | Draft | Up to date | | Samsung Electro-Mechanics 6 | CL10A106KP8NNNC | Volume Production | Worldway Electronics | CL10A106KP8NNNC | 0.0022 | 13.2
| 0201YC221KAT2A | 0201 220 pF 16 V ±10 % Tolerance X7R Surface Mount Multilayer Ceramic Capacitor | C139, C140 | CMP-001-00116-1 | Draft | Up to date | | 2 KYOCERA AVX | 0201YC221KAT2A | Volume Production | Worldway Electronics | 0201YC221KAT2A | 0.0021 | 4.2
| Capacitor 0.1 uF +/-5% 16 V 0402 | Chip Capacitor, 0.1 uF, +/- 5%, 16 V, 0402 (1005 Metric) | C147 | CMP-001-00001-6 | Draft | Up to date | | 1 Murata | GRM155R71C104JA88D | Not Recommended for New Design | Worldway Electronics | GRM155R71C104JA88D | 0.0013 | 1.3
| SBRT3U45SA-13 | DIODE SBR 45V 3A SMA | D1, D2, D3, D4, D5, D6, D7, D8, D9, D10, D12 | CMP-12791-000053-1 | New From Design | Up to date | 11 Diodes Inc. | | SBRT3U45SA-13 | Volume Production | Avnet | SBRT3U45SA-13 | 0.10149 | 1116.39
| PTVS33VP1BPLJ | 600 W Transient Voltage Suppressor | D11, D13, D14, D15, D16, D17, D18 | CMP-11424-155511901-1 | New From Design | Up to date | | 7 Nexperia | PTVS33VP1BPLJ | Volume Production | Farnell | PTVS33VP1BPLJ | 0.20241 | 1416.86
| BM02B-SURS-TF(LF)(SN) | CONN HEADER SMD 2POS 0.8MM | J1 | CMP-17439-000186-1 | New From Design | Up to date | | 1 JST | BM02B-SURS-TF(LF)(SN) | Volume Production | Mouser | 306-BM02BSURSTFLFSN | 0.242 | 242
| FH34SRJ-30S-0.5SH_99_ | 30 Position FFC, FPC Connector Contacts, Top and Bottom 0.020" (0.50mm) Surface Mount, Right Angle -55C ~ 105C,50V,0.5A | J2, J4 | CMP-002-00089-2 | Draft | Up to date | | 2 HIROSE ELECTRIC | FH34SRJ-30S-0.5SH(99) | Volume Production | Worldway Electronics | FH34SRJ-30S-0.5SH(99) | 0.8049 | 1609.8
| FH34SRJ-40S-0.5SH_50_ | 40 Position FFC, FPC Connector Contacts, Top and Bottom 0.020" (0.50mm) Surface Mount, Right Angle | J3 | CMP-002-00090-2 | Draft | Up to date | | 1 HIROSE ELECTRIC | FH34SRJ-40S-0.5SH(50) | Unknown | LCSC | C506798 | 0.203 | 203
| 78171-0004 | Molex PICO-EZMATE 78171, 1.2mm Pitch, 4 Way, 1 Row, Straight PCB Header, Surface Mount | J5 | CMP-002-00091-2 | Draft | Up to date | | 1 Molex | 78171-0004 | Volume Production | Worldway Electronics | 0781710004 | 0.0332 | 33.2
| BM04B-SURS-TF(LF)(SN) | Connector Header Surface Mount 4 position 0.031 (0.80mm) | J6 | CMP-002-00094-1 | Draft | Up to date | | 1 JST | BM04B-SURS-TF(LF)(SN) | Volume Production | Weyland Electronics Group Pte. Ltd. | BM04B-SURS-TF(LF)(SN) | 0.15 | 150
| HC-TYPE-C-16P-CB1.0 | 3A 1 Sink panel 16P Female -25~+85 Type-C SMD USB Connectors ROHS | J7 | CMP-061-000000-2 | Draft | Up to date | | 1 HCTL | HC-TYPE-C-16P-01A-G | Unknown | Unikeyic (ICkey) | HC-TYPE-C-16P-01A-G | 0.0912 | 91.2
| B2B-PH-SM4-TB(LF)(SN) | CONN HEADER SMD 2POS 2MM | J8 | CMP-2000-05163-2 | Released | Up to date | | 1 JST | B2B-PH-SM4-TB(LF)(SN) | Volume Production | Arrow Electronics | B2B-PHSM4-TB(LF)(SN) | 0.2433 | 243.3
| LQP03TNR11H02D | Film type RF Inductor 110nH ±3% 80mA 12Ω 0201 (0603) | L1 | CMP-06042-000419-1 | New From Design | Up to date | | 1 Murata | LQP03TNR11H02D | Volume Production | Mouser | 81-LQP03TNR11H02D | 0.023 | 23
| LQM2HPN2R2MJ0L | Inductor Power Chip Shielded Multi-Layer 2.2uH 20% 1MHz Ferrite 1A 0.15Ohm DCR 1008 T/R | L2, L3 | CMP-006-00026-1 | Draft | Up to date | | 2 Murata | LQM2HPN2R2MJ0L | Volume Production | Chipsmall Limited | LQM2HPN2R2MJ0L | 0.033 | 66
| LQM2HPN2R2MJ0L | Multilayer Type Inductor for Power Lines, 1008 (2520), 2.2μH, 20%, 0.15Ω, 1000mA | L4, L5 | CMP-06042-016476-1 | New From Design | Up to date | | 2 Murata | LQM2HPN2R2MJ0L | Volume Production | Avnet | LQM2HPN2R2MJ0L | 0.05671 | 170.13
| LQM18DN100M70L | General Purpose Inductor, 10uH, 20%, 1 Element, Ferrite-Core, Reflow soldering, , 1608/0603 | L6 | CMP-006-00027-1 | Draft | Up to date | | 1 Murata | LQM18DN100M70L | New Product | Axis Part Limited | LQM18DN100M70L | 0.03849 | 38.49
| LQM18DN100M70L | Multilayer type Inductor for Power Lines 10uH ±20% @1MHz, 300mA, Max DCR 1.365Ω, SRF 32MHz | L7 | CMP-06042-017052-1 | New From Design | Up to date | | 1 Murata | LQM18DN100M70L | New Product | DigiKey | 490-LQM18DN100M70LDKR-ND | 0.06858 | 68.58
| DMN3042L-13 | MOSFET N-CH 30V 5.8A SOT23 | Q1, Q2 | CMP-12801-000067-1 | New From Design | Up to date | | 2 Diodes Inc. | DMN3042L-13 | Volume Production | Newark | DMN3042L-13 | 0.107 | 214
| DMN3042L-13 | 720mW(Ta) 12V 1.4V@ 250¦ÌA 20nC@ 10 V 1N 30V 26.5m¦¸@ 5.8A, 10V 5.8A 860pF@15V SOT-23-3 | Q3, Q4, Q5, Q6 | CMP-013-00042-1 | Draft | Up to date | | 4 Diodes Inc. | DMN3042L-13 | Volume Production | Esaler Electronic | DMN3042L-13 | 0.082 | 328
| RMCF0201JT100R | Res Thick Film 0201 100 Ohm 5% 0.05W(1/20W) ±200ppm/C Pad SMD Automotive T/R | R1, R4, R60, R64 | CMP-009-00212-1 | Draft | Up to date | | 4 Stackpole Electronics | RMCF0201JT100R | Volume Production | Chipsmall Limited | RMCF0201JT100R | 0.00174 | 6.96
| RMCF0201JT3R30 | Fixed Resistor, Metal Glaze/thick Film, 0.05W, 3.3ohm, 25V, 5% +/-Tol, 400ppm/Cel, Surface Mount, 0201 | R2 | CMP-009-00206-1 | Draft | Up to date | | 1 Stackpole Electronics | RMCF0201JT3R30 | Volume Production | Arrow Electronics | RMCF0201JT3R30 | 0.002 | 100
| MCRE000140 | Res General Purpose Thick Film 0201 1k Ohm 1% 1/20W ±200ppm/°C Molded Paper T/R | R3 | CMP-009-00208-1 | Draft | Up to date | | 1 Multicomp | MCRE000140 | Volume Production | Newark | MCRE000140 | 0.008 | | 8
| HCJ0201ZT0R00 | Resistor Jumper Metal Plate 0201 0 Ohm Molded SMD Paper T/R | R5, R21, R24, R31, R36, R62, R63, R70, R77, R78, R79 | CMP-009-00230-1 | Draft | Up to date | 11 Stackpole | Electronics | HCJ0201ZT0R00 | Volume Production | UnikeyIC | HCJ0201ZT0R00 | 0.0835 | 918.5
| CRCW020122R0JNED | Resistor Thick Film 0201 22 Ohm 5% 1/20W 200ppm/C Molded SMD Paper T/R | R6, R43, R44, R52, R53, R54, R56 | CMP-009-00226-1 | Draft | Up to date | | 7 Vishay | CRCW020122R0JNED | Volume Production | TTI | CRCW020122R0JNED | 0.0035 | 35
| ERJ-1GNF2261C | Res Thick Film 0201 2.26K Ohm 1% 1/20W ±200ppm/°C Molded SMD SMD T/R | R11 | CMP-009-00232-1 | Draft | Up to date | | 1 Panasonic | ERJ-1GNF2261C | Volume Production | Easev | ERJ-1GNF2261C | 0.00262 | 2.62
| RT0201BRE0710KL | Fixed Resistor, Thin Film, 0.05W, 10000ohm, 25V, 0.1% +/-Tol, 50ppm/Cel, Surface Mount, 0201 | R14, R15, R17, R27, R28, R29, R30, R32, R34, R37, R38, R39, R40, R42, R45, R48, R51, R57, R61, R68 | CMP-009-00210-1 | Draft | Up to date | 20 Yageo Group | | RT0201BRE0710KL | Volume Production | ODG (Origin Data Global) | RT0201BRE0710KL | 0.0818 | 1636
| RMCF0201JT4K70 | Res Thick Film 0201 4.7K Ohm 5% 0.05W(1/20W) ±200ppm/C Pad SMD Automotive T/R | R16, R18, R41, R46, R47, R49 | CMP-009-00207-1 | Draft | Up to date | | 6 Stackpole Electronics | RMCF0201JT4K70 | Volume Production | Avnet | RMCF0201JT4K70 | 0.00177 | 17.7
| CRCW020156K0JNED | CRCW FIXED RESISTOR 0201 (0603Metric) Chip Resistor ±5% ±200ppm/C 56kOhm 0.05W 1/ 20W | R19 | CMP-009-00227-1 | Draft | Up to date | | 1 Vishay | CRCW020156K0JNED | Volume Production | Esaler Electronic | CRCW020156K0JNED | 0.006 | | 6
| RMCF0201JT2K00 | Res Thick Film 0201 2K Ohm 5% 0.05W(1/20W) ±200ppm/C Pad SMD Automotive T/R | R20, R23 | CMP-009-00231-1 | Draft | Up to date | | 2 Stackpole Electronics | RMCF0201JT2K00 | Volume Production | Fly-Wing Technology | RMCF0201JT2K00 | 0.0051 | 10.21
| RMCF0201JT100R | Res Thick Film 0201 100 Ohm 5% 0.05W(1/20W) ±200ppm/C Pad SMD Automotive T/R | R22, R26, R33, R35, R72 | CMP-009-00229-1 | Draft | Up to date | | Stackpole Electronics 5 | RMCF0201JT100R | Volume Production | Chipsmall Limited | RMCF0201JT100R | 0.00174 | 8.7
| CRCW020139K0JNED | CRCW FIXED RESISTOR 0201 (0603Metric) Chip Resistor ±5% ±200ppm/C 39kOhm 0.05W 1/ 20W | R25 | CMP-009-00228-1 | Draft | Up to date | | 1 Vishay | CRCW020139K0JNED | Volume Production | Esaler Electronic | CRCW020139K0JNED | 0.005 | | 5
| RMCF0201JT47K0 | Res Thick Film 0201 47K Ohm 5% 0.05W(1/20W) ±200ppm/C Pad SMD Automotive T/R | R50, R58, R59 | CMP-010-00030-1 | Draft | Up to date | | Stackpole Electronics 3 | RMCF0201JT47K0 | Volume Production | Fly-Wing Technology | RMCF0201JT47K0 | 0.0051 | 15.31
| AF0201FR-07499RL | 50mW Thick Film Resistors ±1% ±200ppm/℃ 499Ω 0201 Chip Resistor - Surface Mount ROHS | R55 | CMP-009-00220-1 | Draft | Up to date | | 1 Yageo Group | AF0201FR-07499RL | Volume Production | GoKey Chip Technology Co. Inc. | AF0201FR-07499RL | 0.0036 | 3.6
| CRG0201F100K | Res General Purpose Thick Film 0201 100k Ohm 1% 1/20W ±200ppm/°C Molded Paper T/R | R65, R69 | CMP-009-00205-1 | Draft | Up to date | | 2 TE Connectivity | CRG0201F100K | Volume Production | Farnell | CRG0201F100K | 0.02348 | 46.96
| CRCW020122K0JNED | Res Thick Film 0201 22K Ohm 5% 0.05W(1/20W) ±200ppm/C Pad SMD T/R | R66 | CMP-009-00235-1 | Draft | Up to date | | 1 Vishay | CRCW020122K0JNED | Volume Production | Arrow Electronics | CRCW020122K0JNED | 0.0007 | 0.7
| CRCW02015K10JNED | CRCW FIXED RESISTOR 0201 (0603Metric) Chip Resistor ±5% ±200ppm/C 5.1kOhm 0.05W 1/ 20W | R67, R71, R73 | CMP-009-00233-1 | Draft | Up to date | | 3 Vishay | CRCW02015K10JNED | Volume Production | Esaler Electronic | CRCW02015K10JNED | 0.008 | 24
| RMCF0201JT13K0 | Res Thick Film 0201 13K Ohm 5% 0.05W(1/20W) ±200ppm/C Pad SMD T/R | R74 | CMP-009-00234-1 | Draft | Up to date | | 1 Stackpole Electronics | RMCF0201JT13K0 | Volume Production | Avnet | RMCF0201JT13K0 | 0.00177 | 17.7
| RMCF0201JT2R20 | Res Thick Film 0201 2.2 Ohm 5% 0.05W(1/20W) ±400ppm/C Pad SMD T/R Automotive AEC-Q200 | R75, R76 | CMP-009-00236-1 | Draft | Up to date | | Stackpole 2 Electronics | RMCF0201JT2R20 | Volume Production | Avnet | RMCF0201JT2R20 | 0.00177 | 17.7
| EVQ-Q2H03W | SWITCH TACTILE SPST-NO 0.02A 15V | SW1, SW2 | CMP-05618-000002-1 | New From Design | Up to date | | 2 Panasonic | EVQ-Q2H03W | Volume Production | Future Electronics | EVQ-Q2H03W | 0.129 | 258
| B3FS-1012P | SWITCH TACTILE SPST-NO 0.05A 24V | SW3 | CMP-08834-000024-1 | New From Design | Up to date | | 1 Omron | B3FS-1012P | Volume Production | RS (Formerly Allied Electronics) | B3FS-1012P | 0.3 | 300
| JS203011AQN | SWITCH SLIDE DP3T 300MA 6V | SW4 | CMP-10038-000017-1 | New From Design | Up to date | | 1 C&K Components | JS203011AQN | Volume Production | Mouser | 611-JS203011AQN | 0.486 | 486
| Amlogic A311D2 | he Amlogic A311D2 features four Cortex-A73 cores, four Cortex-A53 cores, and a more powerful Mali-G52 MP8 (8EE) GPU that supports OpenGL ES 3.2, Vulkan 1.1, and 0penCL 2.0 graphics programs | U1 | CMP-020-00029-1 | Draft | Up to date | | 1 Khadas | KVIM4-N-01 | Unknown | DigiKey | 2064-KVIM4-N-01-ND | 285.72 | 285722
| PCF8563T/5,518 | IC RTC CLK/CALENDAR I2C 8-SOIC | U2 | CMP-10083-000010-1 | New From Design | Up to date | | 1 NXP Semiconductors | PCF8563T/5,518 | Volume Production | Mouser | 771-PCF8563T/5518 | 0.539 | 539
| STM32G031K6U6 | Mainstream Arm Cortex-M0+ MCU with 32 Kbytes of Flash memory, 8 Kbytes RAM, 64 MHz CPU, 2x USART, timers, ADC, comm. I/F, 1.7-3.6V | U3 | CMP-031-00007-2 | Draft | Up to date | | 1 STMicroelectronics | STM32G031K6U6 | Volume Production | Worldway Electronics | STM32G031K6U6 | 0.4805 | 480.5
| MT53D1024M32D4DT-046_AIT_D | IC DRAM 32GBIT 2133MHZ 200VFBGA | U4 | CMP-038-000000-3 | Draft | Up to date | | 1 Micron | MT53D1024M32D4DT-046 AIT:D | Obsolete | Easev | MT53D1024M32D4DT-046 AIT:D | 8.84 | 8840.43
| KLMAG2GEND-B031 | SAMSUNG eÂ·MMC is an embedded MMC solution designed in a BGA package form | U5 | CMP-040-000000-1 | Draft | Up to date | | 1 Samsung | KLMAG2GEND-B031 | Unknown | ICPartonline | KLMAG2GEND-B031 | 2.55 | 2550
| TPS2115ADRBR | IC OR CTRLR SRC SELECT 8SON | U6 | CMP-0339-00011-3 | New From Design | Up to date | | 1 Texas Instruments | TPS2115ADRBR | Volume Production | Arrow Electronics | TPS2115ADRBR | 1.17 | 1170.3
| TPS2121RUXR | PWR MGMT BATTERY MGMT | U7 | CMP-04910-000009-1 | New From Design | Up to date | | 1 Texas Instruments | TPS2121RUXR | Volume Production | Arrow Electronics | TPS2121RUXR | 1.25 | 1250.7
| WS2812B-B | Intelligent control LED integrated light source | U8, U9, U10, U11, U13, U14, U17, U18, U19, U20, U21, U22, U23, U24, U25, U26 | CMP-067-000000-1 | Draft | Up to date | 16 Worldsemi | | WS2812B BLACK | Unknown | TME | WS2812B-B | 0.12 | 1920
| MAX98357AETE+T | Tiny, Low-Cost, PCM Class D Amplifier with Class AB Performance | U12 | CMP-014-00003-2 | Draft | Up to date | | 1 Analog Devices | MAX98357AETE+T | Volume Production | ALLICDATA ELECTRONICS | MAX98357AETE+T | 0.1302 | 130.2
| IM67D120AXTSA1 | IM67D120AXTSA1 MEMS Microphone Omni-Directional -26dB 1.62V to 3.6V 5-Pin LLGA-5-4 Solder Pad T/R | U15, U16 | CMP-00196-121674314-1 | New From Design | Up to date | | 2 Infineon | IM67D120AXTSA1 | Volume Production | Mouser | 726-IM67D120AXTSA1 | 1.06 | 2120
| ABM3B-24.000MHZ-B2-T | Ceramic SMD Crystal, 24 MHz, +/- 20 ppm, 18 pF, -20 to 70 degC, 4-Pin SMD, RoHS, Tape and Reel | X1 | CMP-003-00019-2 | Draft | Up to date | | 1 Abracon | ABM3B-24.000MHZ-B2-T | Volume Production | Win Source | WS-ABM3B-24.000MHZ-B2-T | 0.3714 | 371.4
| ABS06-127-32.768KHZ-T | Crystal 32.768kHz ±20ppm (Tol) 12.5pF FUND 90kΩ 2-Pin Mini-CSMD T/R | Y1 | CMP-27762-015939-1 | New From Design | Up to date | | 1 Abracon | ABS06-127-32.768KHZ-T | Volume Production | Mouser | 815-ABS0612732.768KT | 0.987 | 987
| ABM13W-37.4000MHZ-5-K1Z-T5 | Crystal 37.4MHz ±10ppm 5pF SMD-4 1.2mm x 1mm | Y2 | CMP-27762-010000-1 | New From Design | Up to date | | 1 Abracon | ABM13W-38.4000MHZ-8-NH7U-T5 | Volume Production | Aztech | ABM13W-38.4000MHZ-8-NH7U-T5 | 12.35 | 12350
