juanforozco/Proyecto_Final_DPE/(list of files, drawings)

Other design files:
Main_Board.PcbDoc
Main_Board.SchDoc
Main_Board_Diseño.PrjPcb
Power_Board_Diseño/DFN1X1.SchDoc
Power_Board_Diseño/DFN1X1_2.SchDoc
Power_Board_Diseño/MP8756GD.SchDoc
Power_Board_Diseño/MP8756GD_2.SchDoc
Power_Board_Diseño/MP8756GD_3.SchDoc
Power_Board_Diseño/MP8756GD_4.SchDoc
Power_Board_Diseño/NB679.SchDoc
Power_Board_Diseño/NB680.SchDoc
Power_Board_Diseño/NCP177.SchDoc
Power_Board_Diseño/Power_Board.PcbDoc
Power_Board_Diseño/Power_Board_Diseño.PrjPcb
Power_Board_Diseño/Supply_Source.SchDoc
Power_Board_Diseño/SY8003ADFC.SchDoc
Power_Board_Diseño/SY8003ADFC_2.SchDoc
Power_Board_Diseño/SY8003ADFC_3.SchDoc
Power_Board_Diseño/SY8003ADFC_4.SchDoc
Power_Board_Diseño/TLV76701.SchDoc
Proyecto_Final_Digitales/Main_Board.PcbDoc
Proyecto_Final_Digitales/Main_Board.SchDoc
Proyecto_Final_Digitales/Main_Board_Diseño.PrjPcb
Proyecto_Final_Digitales/test/DFN1X1.SchDoc
Proyecto_Final_Digitales/test/DFN1X1_2.SchDoc
Proyecto_Final_Digitales/test/MP8756GD.SchDoc
Proyecto_Final_Digitales/test/MP8756GD_2.SchDoc
Proyecto_Final_Digitales/test/MP8756GD_3.SchDoc
Proyecto_Final_Digitales/test/MP8756GD_4.SchDoc
Proyecto_Final_Digitales/test/NB679.SchDoc
Proyecto_Final_Digitales/test/NB680.SchDoc
Proyecto_Final_Digitales/test/NCP177.SchDoc
Proyecto_Final_Digitales/test/Supply_Source.SchDoc
Proyecto_Final_Digitales/test/SY8003ADFC.SchDoc
Proyecto_Final_Digitales/test/SY8003ADFC_2.SchDoc
Proyecto_Final_Digitales/test/SY8003ADFC_3.SchDoc
Proyecto_Final_Digitales/test/SY8003ADFC_4.SchDoc
Proyecto_Final_Digitales/test/TLV76701.SchDoc
test/DFN1X1.SchDoc
test/DFN1X1_2.SchDoc
test/MP8756GD.SchDoc
test/MP8756GD_2.SchDoc
test/MP8756GD_3.SchDoc
test/MP8756GD_4.SchDoc
test/NB679.SchDoc
test/NB680.SchDoc
test/NCP177.SchDoc
test/Supply_Source.SchDoc
test/SY8003ADFC.SchDoc
test/SY8003ADFC_2.SchDoc
test/SY8003ADFC_3.SchDoc
test/SY8003ADFC_4.SchDoc
test/TLV76701.SchDoc
